DaveWindWatcher/Design-Tools/Practiques/Practica4/pcb-wallpaper.png

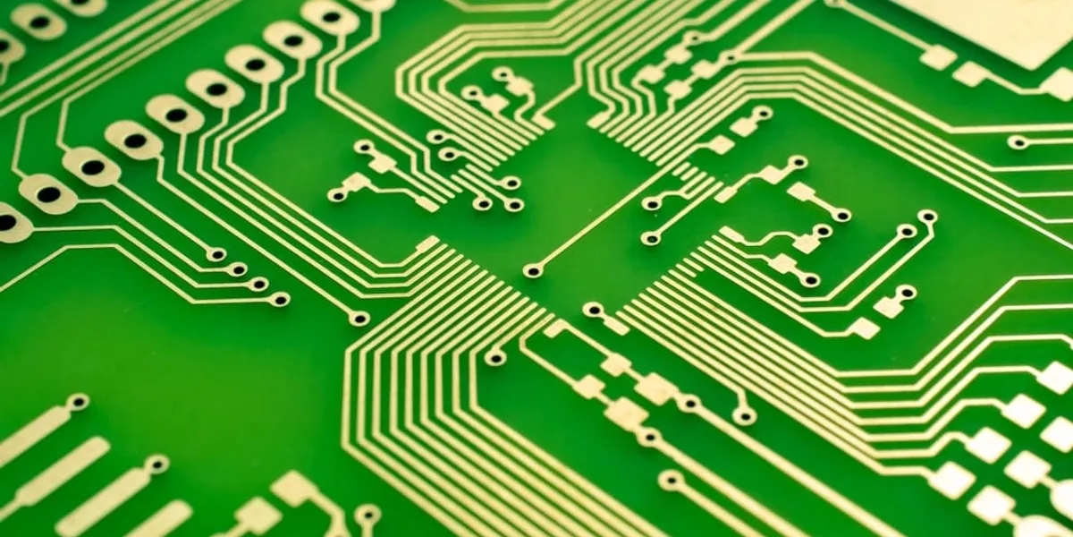
Practiques/Practica4/pcb-wallpaper.png
