DaveWindWatcher/Design-Tools/Practiques/Practica4/Fotitos/1679039151660.jpg

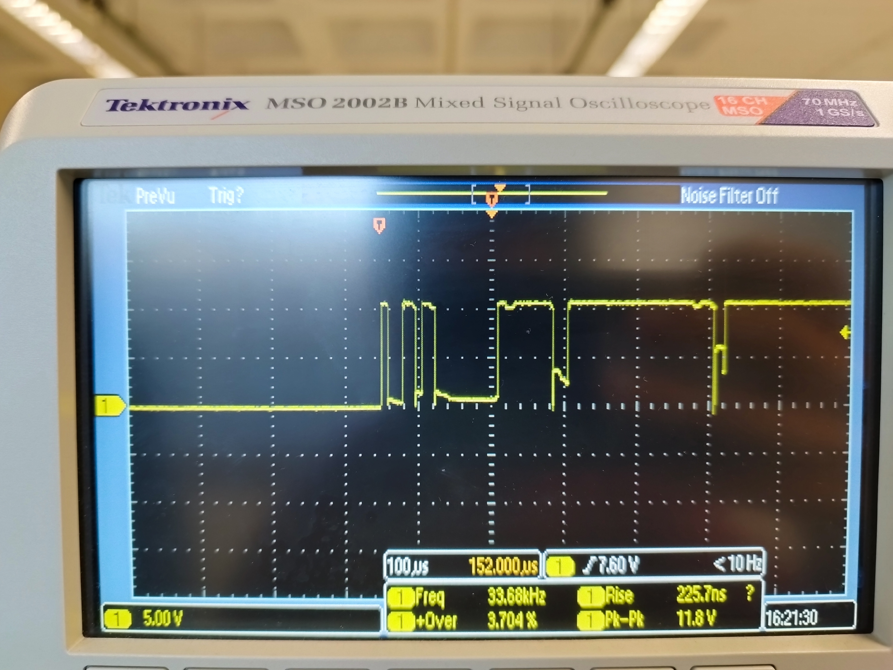
Practiques/Practica4/Fotitos/1679039151660.jpg
