DaveWindWatcher/Design-Tools/README.md

# Design-Tools

Space for the Projects of the subject Dessigns Tool of the Elecronics Engineering Degree.

This course is mainly about PCB design and everything related to it. It is a very practical and application focused course, where students acquire skills in circuit and PCB design. From the conceptualization to the testing pahse and, eventually, the commercialization, going through block diagram and component gathering, schematic and layout and verification. 

### Contents
	I. Practiques
		
		Folder with Lab training, mostly about PCB design.
		
		I.I.	Practica1
		I.II.	Practica2
		I.III.	Practica3
		I.IV.	Practica4
		I.V.	Projecte
