DaveWindWatcher/Design-Tools/Teoria/Ch4 -Decoupling.pdf

### Criteris de Disseny. Cap. IV

### Placement of components

### Component Placement Rules

- Els criteris per col·locar els components en una PCB
– En un circuit d'alta sensibilitat, els components crítics es col·loquen primer, de tal manera que requereixi la mínima longitud de pista per unir els components crítics
– La circuiteria menys crítica es col·loca en l'ordre del flux del senyal. Això minimitzarà la mida de les línies conductores de senyal.
– En un circuit on uns pocs components tenen un nombre considerable de punts de connexió, aquests components seran col·locats primer, distribuint la resta al voltant d'ells

### Component Placement Rules

– Com a regla general, col·loquem primers els components que queden fixats per la seva importància en el circuit, els connectors i interconnexions. Posteriorment es col·loquen la resta de components que es connecten a aquests components primers.
– En quant a la distribució en mida, es col·loquen primer els components més grans, omplint l'espai restant amb els components més petits. – Els components s'han de col·locar de tal forma que sigui senzilla la seva localització a la placa

### Apantallant circuits sensibles

### Soroll i Regles de Disseny

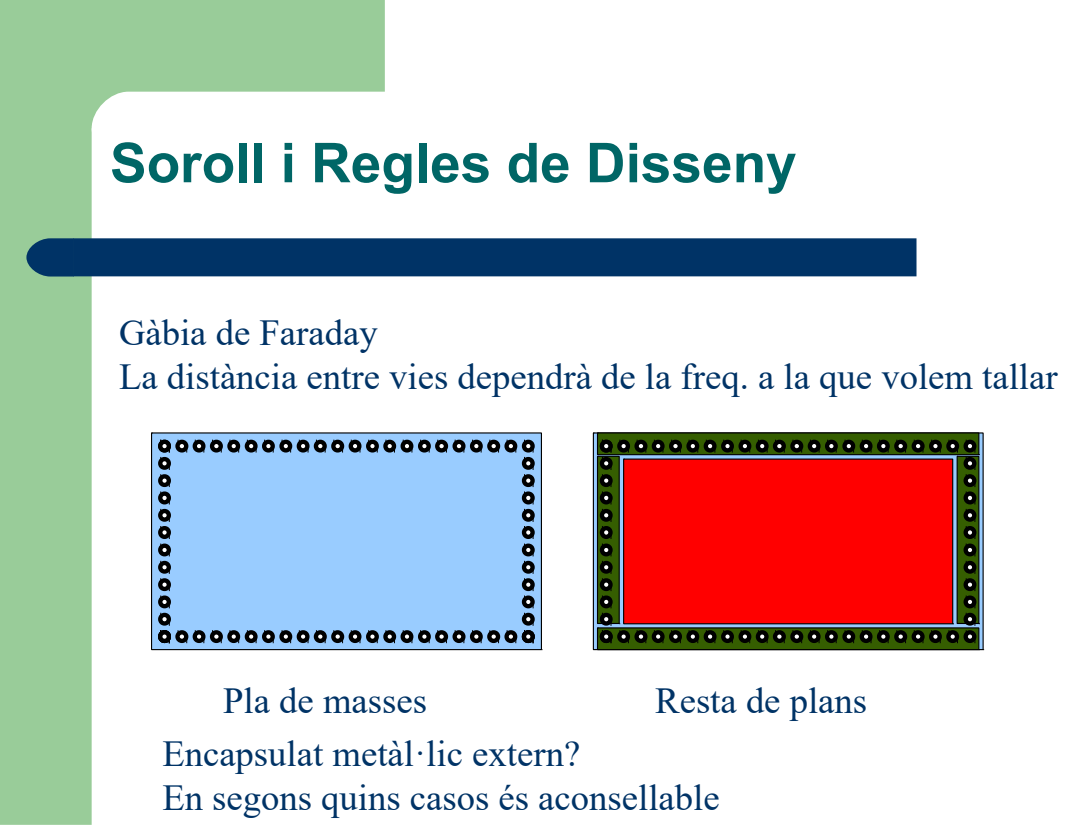
[picture p13: page 6]
Pla de masses; Resta de plans

Gàbia de Faraday
La distància entre vies dependrà de la freq. a la que volem tallar

Encapsulat metàl·lic extern?
En segons quins casos és aconsellable

- La “Gàbia de Faraday” permet contenir las EMI en els perímetres on es poden generar senyals d'altra freqüència
- No està permesa senyals d'entrada / sortida excepte aquelles senyals de comunicació amb l'exterior, i tot i així, degudament filtrades
- Evitar les masses flotants: Les masses flotants o stuffs són penínsules de coure que pengen d'un punt d'unió de masses

### Soroll i Regles de Disseny

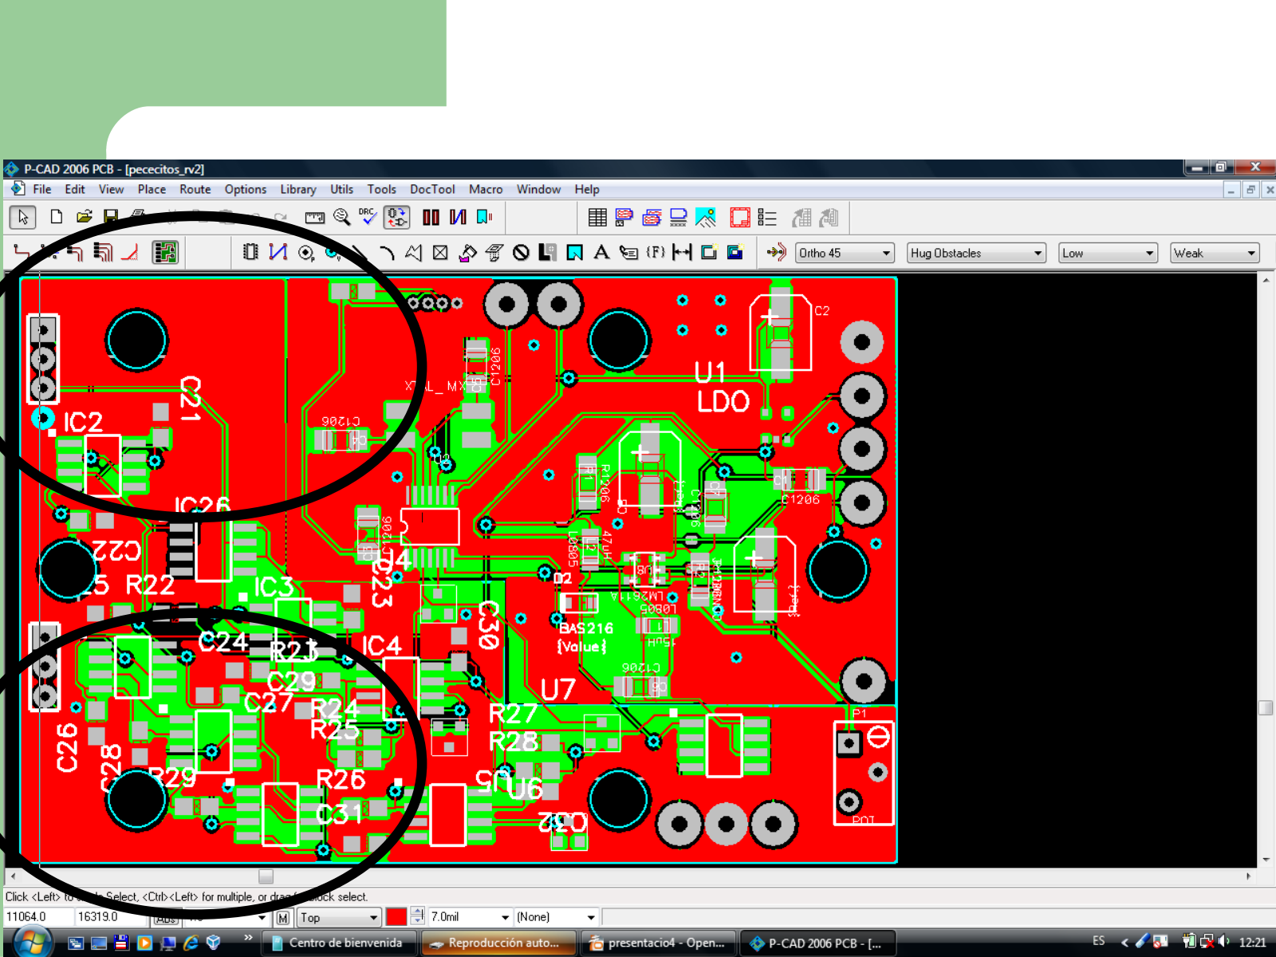
[picture p14: page 8]

### Desacoblament de circuits

### Soroll i Regles de Disseny

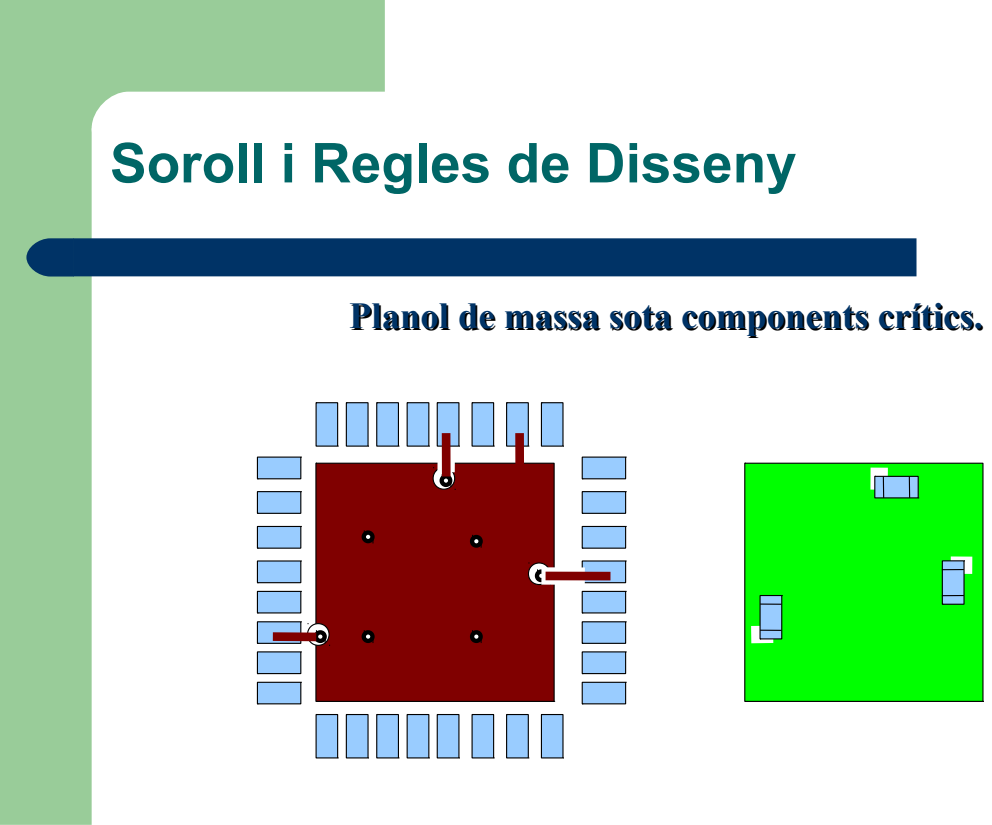
[picture p15: page 10]

Planol de massa sota components crítics.

### Power Supply Decoupling

- El desacoblament de de la font d'alimentació vol dir la disassociació del circuit d'alimentació del bus que dona servei al circuit. Els efectes avantatjosos que presenten són:
– Redueix l'efecte d'un circuit integrat (IC) sobre un altre (Inter-IC-coupling)
– Proporciona una baixa impedància entre Vcc i GND. El IC opera tal i com especifica el fabricant i els enginyers. (Intra-IC-coupling)

### Power Supply Decoupling

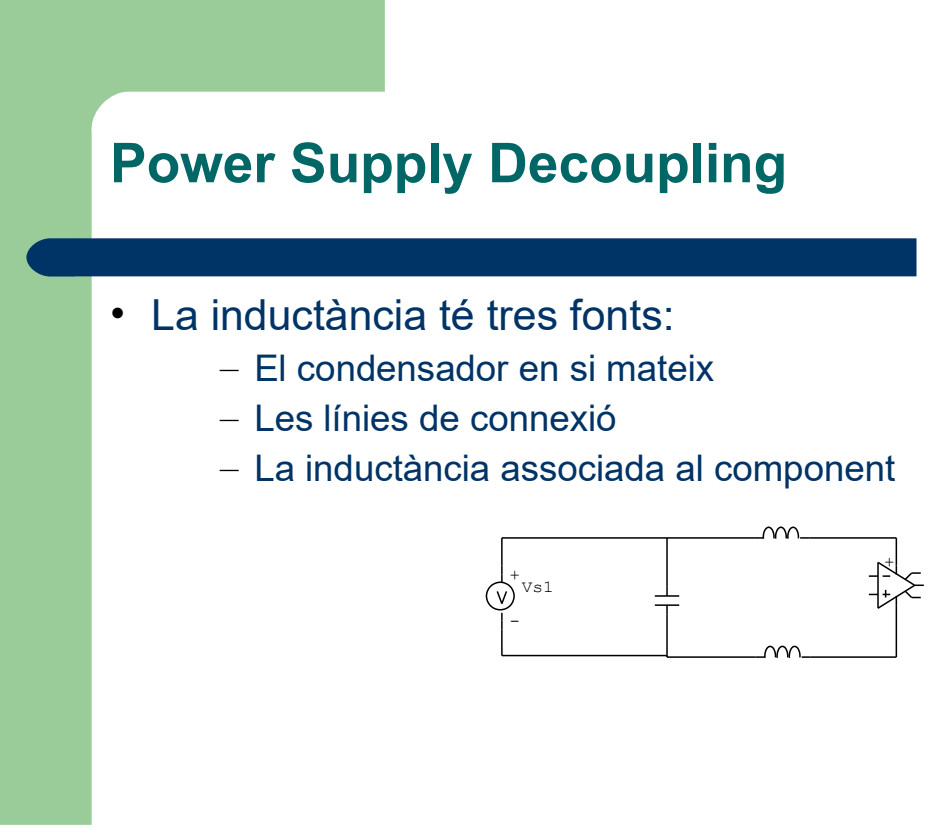
[picture p16: page 12]

• La inductància té tres fonts:
– El condensador en si mateix
– Les línies de connexió
– La inductància associada al component

### Power Supply Decoupling

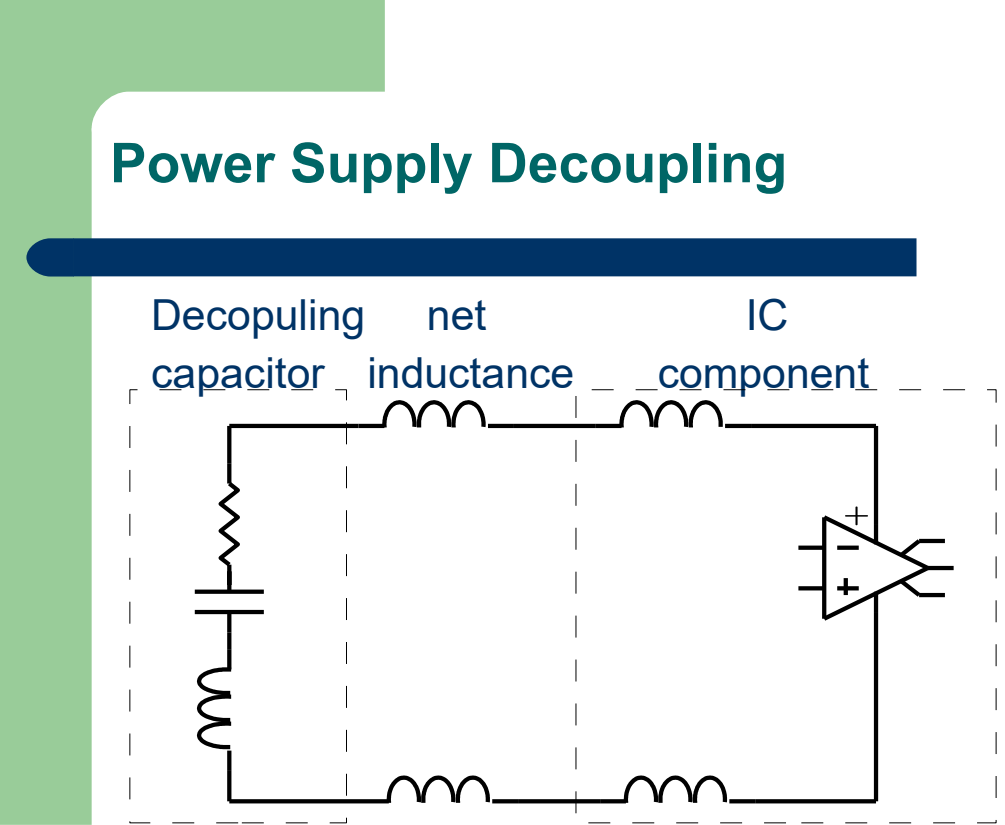
[picture p17: page 13]
Decopuling; net; capacitor inductance; component

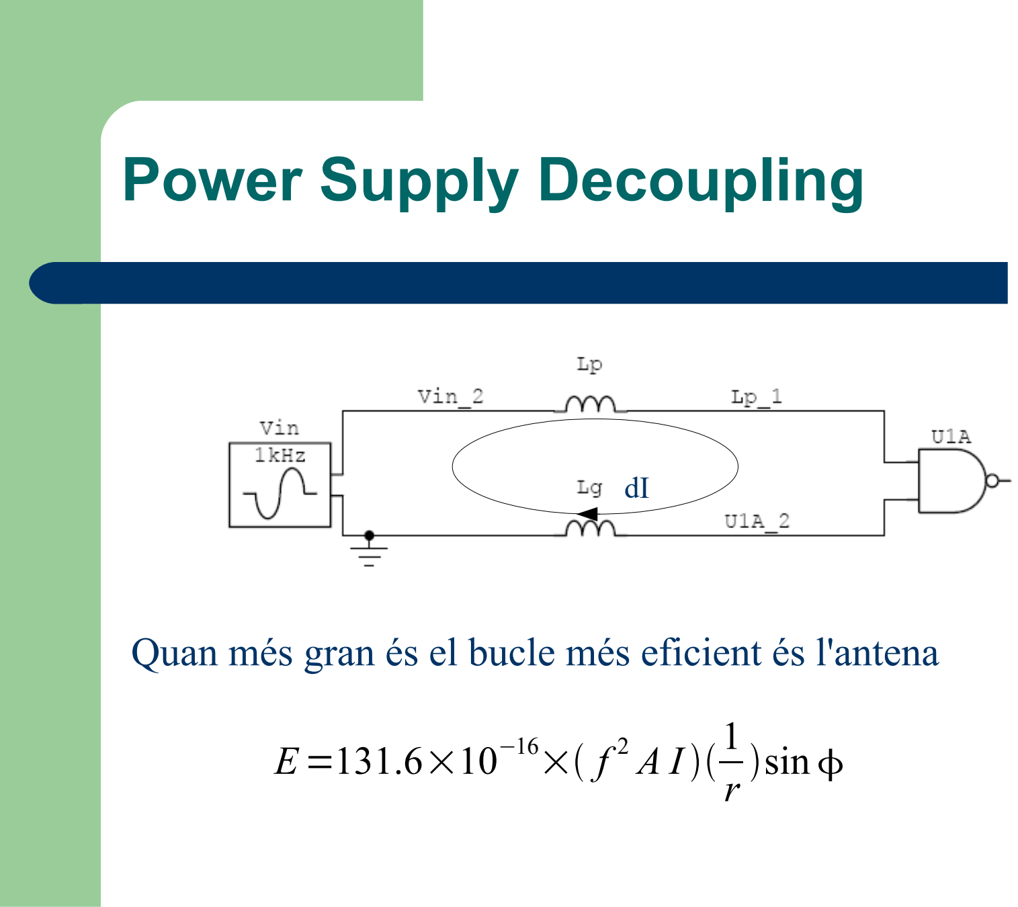
[picture p18: figure]
Power Supply Decoupling; sin

Quan més gran és el bucle més eficient és l'antena

### Power Supply Decoupling

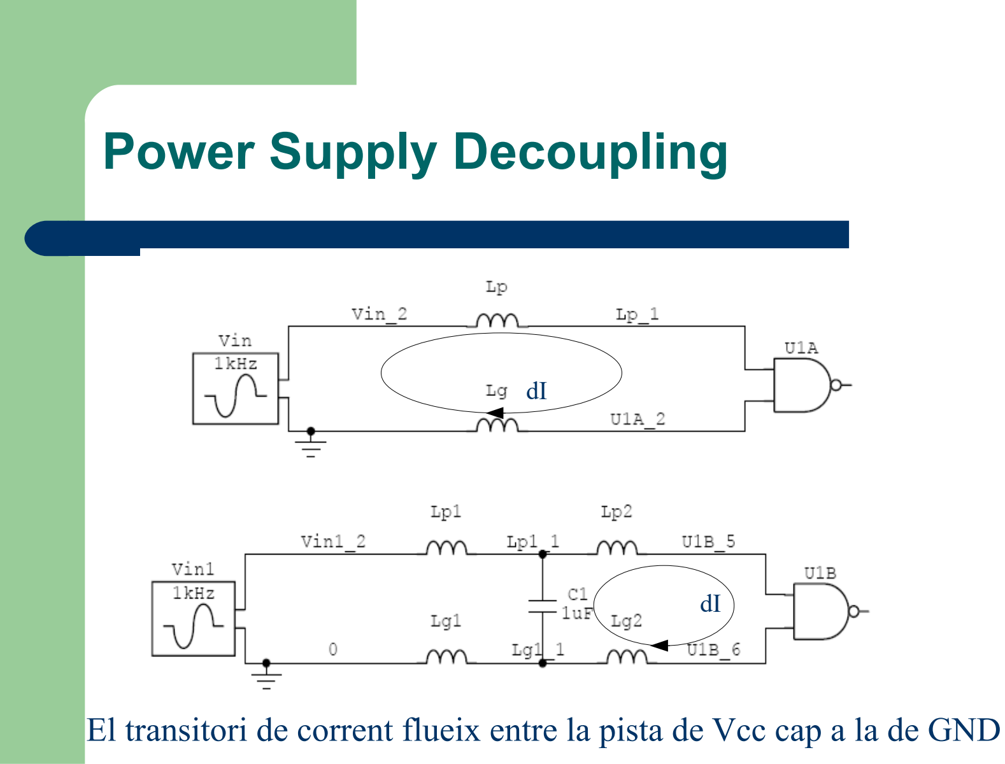
[picture p19: page 15]

dI

dI

El transitori de corrent flueix entre la pista de Vcc cap a la de GND

### Power Supply Decoupling

- El condensador de desacoblament té dos propòsits:
– Proporciona una font de càrrega propera al IC, per tant quan l'IC commuta, el condensador suministra el corrent necessari pel transitori per un camí de baixa impedància
– Proporciona una baixa impedància en AC entre Vcc i GND, minimitzant el soroll injectat en el sistema Vcc/GND per l' IC.

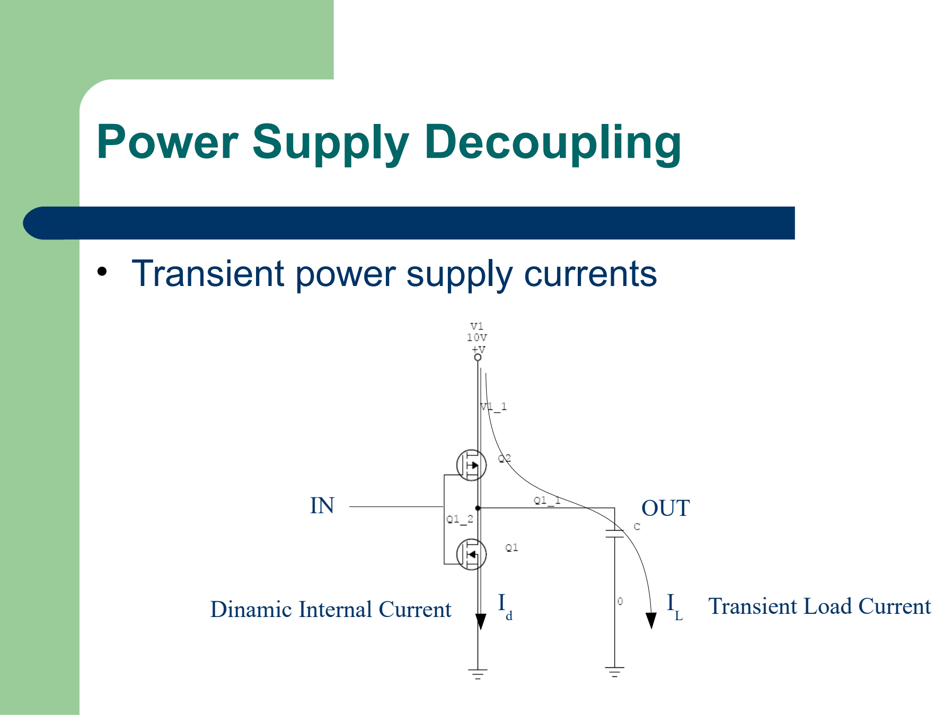
[picture p20: figure]
Power Supply Decoupling; • Transient power supply currents; OUT; I Dinamic Internal Current; Transient Load Current

### Power Supply Decoupling

- Transient Load Current
Aquest fenòmen el trobem associat a la capacitat que tenim a l'entrada de molts Ics – Per exemple, una porta CMOS té una capacitat d'entrada de 7 a 12 pF
El corrent que s'ha de suministrar serà:
- P.e. Un IC operant a 5V amb tr = 1ns té a la sortida 10 CMOS amb 10 pF, Quan val I
L

?

I

L=

nCLV CC
t
r

### Power Supply Decoupling

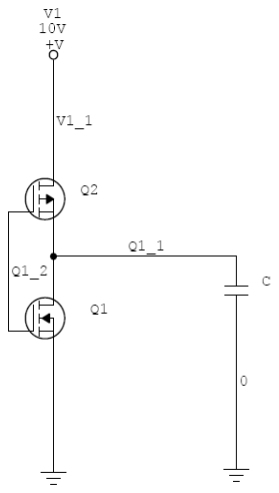
[picture p21: figure]

- Dinamic Internal Current
- Quan un circuit com el de la figura commuta, hi ha un
instant en el que els dos
transistors estan
parcialment conduint,
produint una baixa
impedància entre Vcc i
GND

### Power Supply Decoupling

- El pic de corrent es pot calcular de dos formes en funció de les especs. del datasheet
– Si ens proporcionen la Capacitat de dissipació de potència, Cpd

equivalent a la capacitat interna de l' IC
– En d'altres IC datasheets indiquen el corrent dinàmic d'alimentació ICCD amb unitats A/MHz
I

d=I CCD f
0

o
I

d=

nC pdV CC
t
r

### Power Supply Decoupling

- Espectre de Fourier del transitori de corrent
- Considerant l'aproximació que l'ona de corrent s'aproxima a un triangle isòsceles, l'amplitud del corrent pels diferents

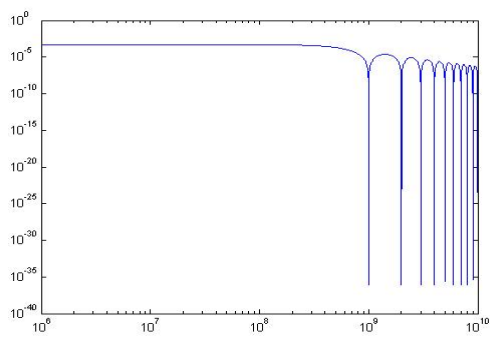
[picture p22: figure]

harmònics ve donada per:

- L'envolvent dels harmònics per una relació tr/T de 0.001 és

I n

=

2 I t
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
### Power Supply Decoupling

- Per sobre d'una freqüència 1/PI tr (freqüència de tall), els harmònics decauen uns 40 dB/dec

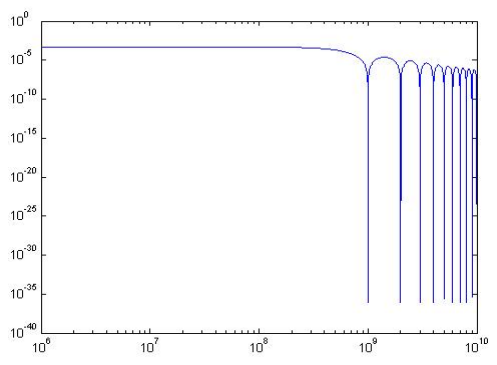
[picture p23: figure]

La freq. de tall ocurrirà a una
freqüència igual a k vegades la freq. fonamental
k no té per que ser un enter

k=
1
T
t

r

### Power Supply Decoupling

- “It is important to note that decoupling is not the process of placing a capacitor adjacent to an IC to supply the transient switching current. Is the process of placing an L-C network adjacent to an IC to supply the transient current”
Henry W. Ott. Electromagnetic Compatibility Engineering

### Power Supply Decoupling

- La inductància interna d'una capacitat SMD és aproximadament de 1 – 2 nH
- La inductància d'una pista de coure oscil·la entre 5 – 20 nH (o més) depenent de les característiques de la pista. Aquestes són les úniques sobre les que tenim cert control!!
- La inductància interna de un IC té un valor que oscil·la entre 3 – 15 nH
- La freqüència de resonància d'un circuit LC sèrie és f
r=

1
2 LC

### Power Supply Decoupling

w = [100000:100000:1000000000] R = 50;
format long
L = 2*10^-9;
C = 10*10^-9;
wl = 2*pi*w*L;
wc = 2*pi*w*C;
format long
length(w)
for x=1:length(w)
Z_r(x) = 0;%R;
Z_i(x) = (wl(x) -1/wc(x)); x
end
Z = Z_r + Z_i *i;
Zmax = max(abs(Z));

loglog( w,abs(Z)/Zmax);

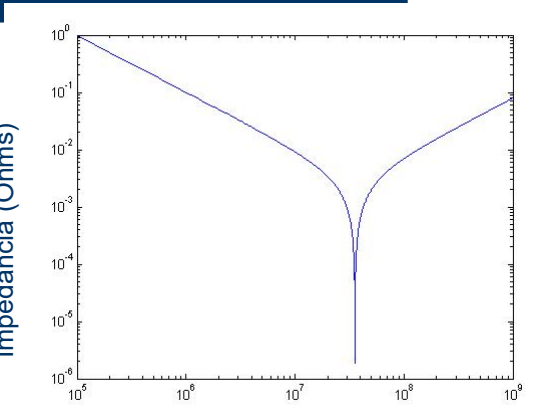
[picture p24: figure]

Freqüència (Hz)

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
### Power Supply Decoupling

- La col·locació d'una capacitad adjacent a un IC és relativament útil per baixes freqüències (per sota dels 50 Mhz)
- En la figura anterior, tenim una capacitat de 10 nF amb una impedància sèrie de 2nH. Veiem que la resonància està cap als 40 Mhz.
- Per sobre d'aquest valor, el comportament és inductiu.

### Power Supply Decoupling

- Tèniques eficiens de desacoblament – Disminuir el Rise Time
– Disminuir el transitori de corrent
– Disminuir la inductància sèrie de les capacitats
– Fer servir múltiples capacitats
- Les dues primeres van contra l'avenç de la tecnologia!! Es poden aplicar en segons quins casos

### Power Supply Decoupling

“Disminuir la inductància en sèrie amb C”
- Disminuir la inductància en sèrie sempre és recomanable en un Circuit integrat, tot i això, en aquest cas no solventa el problema de desacoblament per altes freqüències. Si disminuïm L fins a 1 nH, per una capacitat de 10 nF trobem de nou la freqüència de resonància de 50 MHz

### Power Supply Decoupling

Freqüència ressonància (Mhz) en funció de C i la seva capacitat paràsita

- Per tant no es pot moure la freq. De ressonància de un sol condensador de desacoblament per sobre del centenar de MHz fent servir una capacitat real.
Capacitat (uF) | 5 nH | 10 nH | 15 nH | 20 nH | 30 nH
1 | 2,3 | 1,6 | 1,3 | 1 | 0,9
0,1 | 7,1 | 5 | 4,1 | 3,6 | 3
0,01 | 22,5 | 16 | 13 | 11 | 9
0,001 | 71,2 | 50 | 41 | 36 | 30

### Power Supply Decoupling

- Desacoblament amb múltiples capacitats

– Múltiples capacitats del mateix valor en paral·lel – Múltiples capacitats amb dos valors diferents en paral·lel
– Múltiples capacitats amb molts valors, en paral·lel normalment espaiats una dècada. Per exemple 1uF, 0.1 uF, 0.01 uF, 0.001 uF, 100 pF, etc.

### Power Supply Decoupling

Múltiples capacitats del mateix valor en paral·lel – La capacitat total per n C's del mateix valor és C
t

= nC
– La inductància serà
L
t

= L/n
– Aquesta equació serà correcta si i només si la inductància mútua dels circuits individuals és negligible comparada amb la pròpia inductància. Per tant, les xarxes L-C han d'estar separades físicament per tal de disminuir M.

### Power Supply Decoupling

w = [100000:100000:1000000000] R = 50;
format long
L = 2*10^-9;
C = 10*10^-9;
C1 = 5*10^-9;
C2 = 2.5*10^-9;

wl = 2*pi*w*L;
wc = 2*pi*w*C;
wl1 = 2*pi*w*L/2;
wl2 = 2*pi*w*L/4;
wc1 = 4*pi*w*C1;
wc2 = 8*pi*w*C2;
format long
length(w)
for x=1:length(w)
Z_r(x) = 0;%R;
Z_i(x) = (wl(x) -1/wc(x)); Z_i1(x) = (wl1(x) -1/wc1(x)); Z_i2(x) = (wl2(x) -1/wc2(x)); x
end

Z = Z_r + Z_i *i;
Z1 | = Z_r + Z_i1 *i;
Z2 | = Z_r + Z_i2 *i;
Zmax = max(abs(Z));
Zmax1 = max(abs(Z1));
Zmax2 = max(abs(Z2));

loglog( w,abs(Z)/Zmax);

hold on;

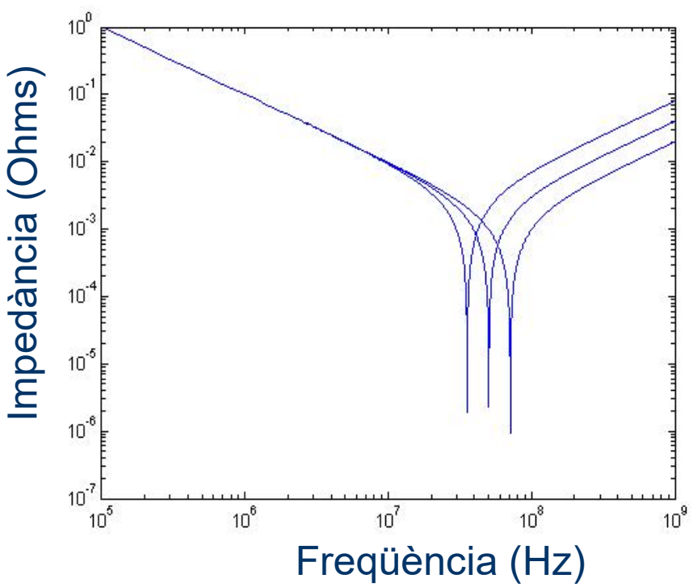
[picture p25: figure]
Freqüència (Hz); cia

loglog(w, abs(Z1)/Zmax1);
hold on;
loglog(w, abs(Z2)/Zmax2);

### Power Supply Decoupling

Múltiples capacitats amb dos valors diferents En algunes circumstàncies es recomana fer servir dos valors de capacitats basant-se en la teoria de que el condensador gran proporcionarà un efectiu desacoblament a baixes freqüències i el petit el proporcionarà a altes freqüències.

### Power Supply Decoupling

- Tenim un problema potencial amb la antiresonància que tenim entre les dues xarxes
- La antiressonància es dona entre les dues freqüències de ressonància de les dues subxarxes.
- La xarxa associada al condensador més petit no te efectes en el desacoblament per freqüències per sota de la freqüència de ressonància del condensador gran

### Power Supply Decoupling

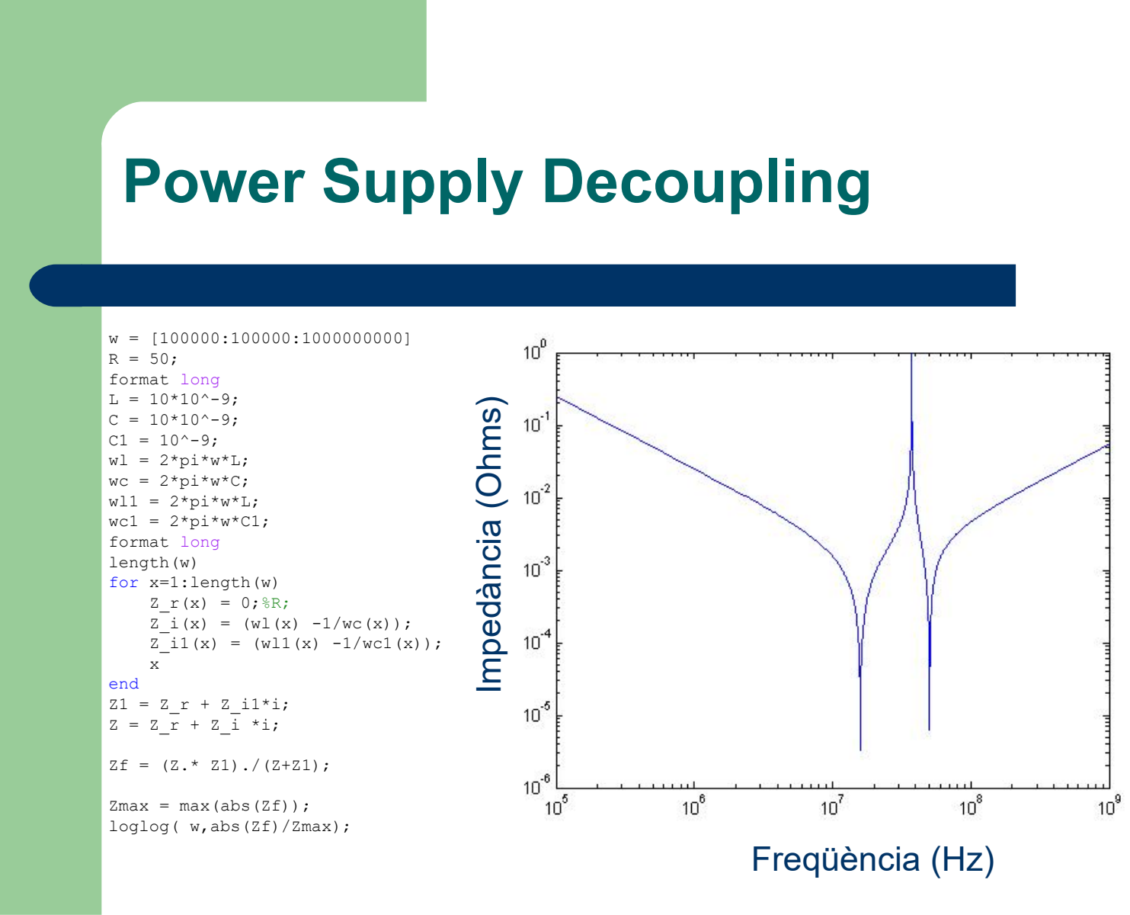
[picture p26: page 35]

w = [100000:100000:1000000000] R = 50;
format long
L = 10*10^-9;
C = 10*10^-9;
C1 = 10^-9;
wl = 2*pi*w*L;
wc = 2*pi*w*C;
wl1 = 2*pi*w*L;
wc1 = 2*pi*w*C1;
format long
length(w)
for x=1:length(w)
Z_r(x) = 0;%R;
Z_i(x) = (wl(x) -1/wc(x)); Z_i1(x) = (wl1(x) -1/wc1(x)); x
end
Z1 = Z_r + Z_i1*i;
Z = Z_r + Z_i *i;

Zf = (Z.* Z1)./(Z+Z1);

Zmax = max(abs(Zf));
loglog( w,abs(Zf)/Zmax);
Freqüència (Hz)

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
### Power Supply Decoupling

- Es millora el desacoblament a freqüències per sobre de la freqüència de ressonància del condensador més petit, ja que la inductància decreix
- El desacoblament serà pitjor a les freqüències intermitjes entre les dues freqüències de ressonància
- Si les dues capacitats tenen una relació 2:1 l'amplitud del pic antiressonat assoleix valors “acceptables”

### Power Supply Decoupling

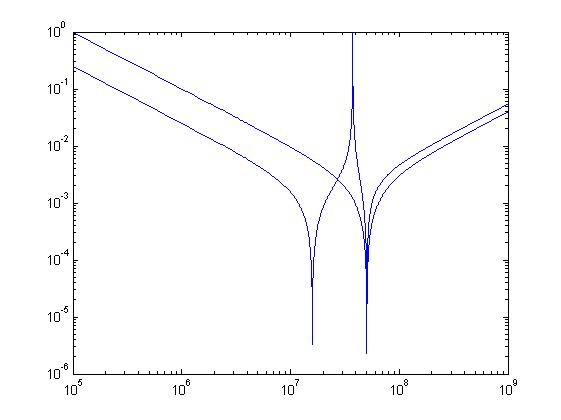
[picture p27: figure]

w = [100000:100000:1000000000] R = 50;
format long
L = 10*10^-9;
C1 = 10*10^-9;
C = 10^-9;
wl = 2*pi*w*L;
wc = 2*pi*w*C;
wl1 = 2*pi*w*L;
wc1 = 2*pi*w*C1;
format long
length(w)
for x=1:length(w)
Z_r(x) = 0;%R;
Z_i(x) = (wl(x) -1/wc(x)); Z_i1(x) = (wl1(x) -1/wc1(x)); x
end
Z1 = Z_r + Z_i1*i;
Z = Z_r + Z_i *i;

Zf = (Z.* Z1)./(Z+Z1);
Zf2 = (Z.*Z)./(2*Z);
Zmax = max(abs(Zf));
loglog( w,abs(Zf)/Zmax);
hold on
Zmax2 = max(abs(Zf2));
loglog( w,abs(Zf2)/Zmax2);

### Power Supply Decoupling

Impedància target
– Per aconseguir una xarxa de desacoblament efectiva, necessitem que la impedància estigui per sota del target pel rang de freqüències d'interès
– Si la impedància target és de 200 mΩ, amb una configuració de 2 capacitats en paral·lel tindrem:

### Power Supply Decoupling

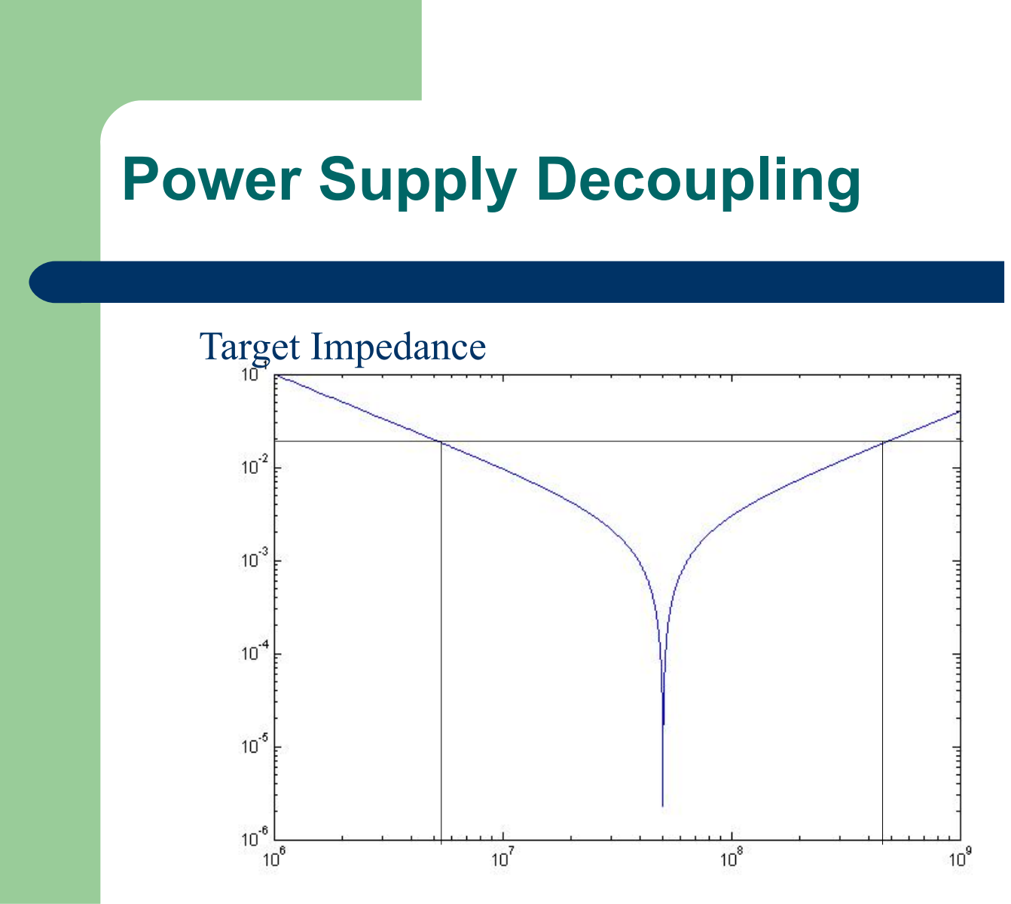
[picture p28: page 39]

Target Impedance

### Power Supply Decoupling

- De l'estudi dels transitoris de corrent en els components sabem que per sobre d'una freq

l'amplitud dels harmònics decauen 40dB/dec. – Per tant la impedància target pot créixer per sobre d'aquesta freqüència sense incrementar el nivell de soroll
– Amb aquesta aproximació podem estimar el nombre de capacitats necessàries per proporcionar un desacoblament efectiu a alta freqüència

f =

1
t
r

### Power Supply Decoupling

- El mínim nombre de capacitats és

L és la inductància de cada capacitat
Z
t

és la impedància objectiu a baixa freq. t
r

és el temps de commutació de la lògica El valor de Z
t

se sol determinar considerant la magnitud del transitori de corrent total i la variació de tensió que permetem per aquest transitori

n=

2 L
Zt

t
r

Zt

=

k dV

dI | k=
1
T
t

r

### Power Supply Decoupling

- Un cop coneguda la impedància objectiu, coneguda la freqüència més baixa d'interès tindrem

El valor de la capacitat obtinguda haurà de satisfer el criteri de transitori de corrent

∣Zt

∣=

1
2 f C

C

dI /dt
dV

### Power Supply Decoupling

Embedded PCB Capacitance
– Si incrementem el nombre de capacitats, en el límit, es pot concloure que la configuració ideal de desacoblament és un nombre infinit de capacitats infinitesimals.
– Per ser efectiva la utilització dels plans de Vcc i GND com capacitats hauria de tenir un valor de uns 1000 pF/in²
– L'espaiat entre capes estàndard es de 0,005 – 0,01 inches, cosa que proporciona una capacitat (FR4) de 1/5 – 1/10 del valor ideal.

C=

Ae
d

1.- La quantitat de corrent necessaria per commutar una sortida de 0 a 1. El nombre de sortides a commutar (N), el temps requerit pel condensador per suministrar corrent (ΔT depen de la freqüència de commutació), i la caiguda de tensió que el sistema pot tolerar ΔV.

C=

I ×N × T
- V

### Power Supply Decoupling

El 18F252A consta de tres ports d'I/O. Dos entades de VCC L'alimentació necessaria són 200mA si commuten tots els pins alhora. ΔV= 0.5V i el temps de commutació està al voltant de 5 nsec.

C=

I×N ×Δ T
Δ V

=

200×20×10×10⁻⁹
0.5

=40 nF

### Power Supply Decoupling

### Power Supply Decoupling

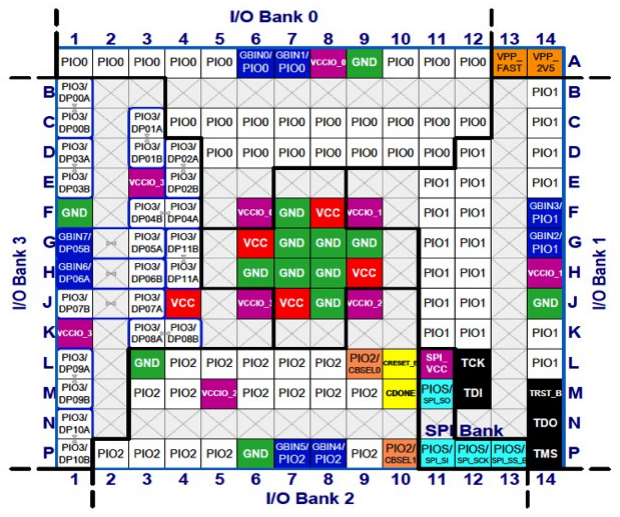
[picture p29: figure]

### Power Supply Decoupling

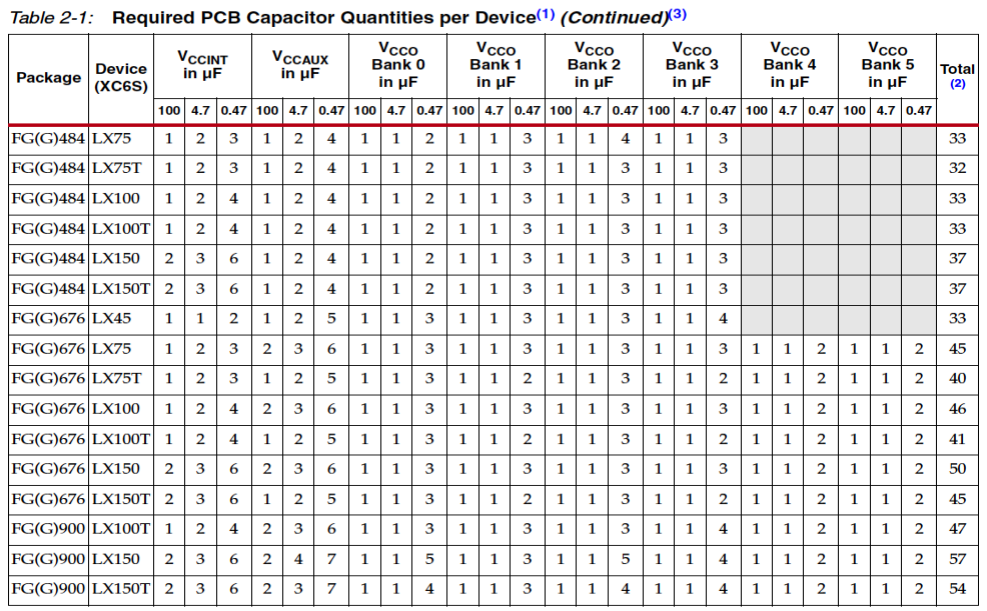
[picture p30: figure]

### Power Supply Decoupling

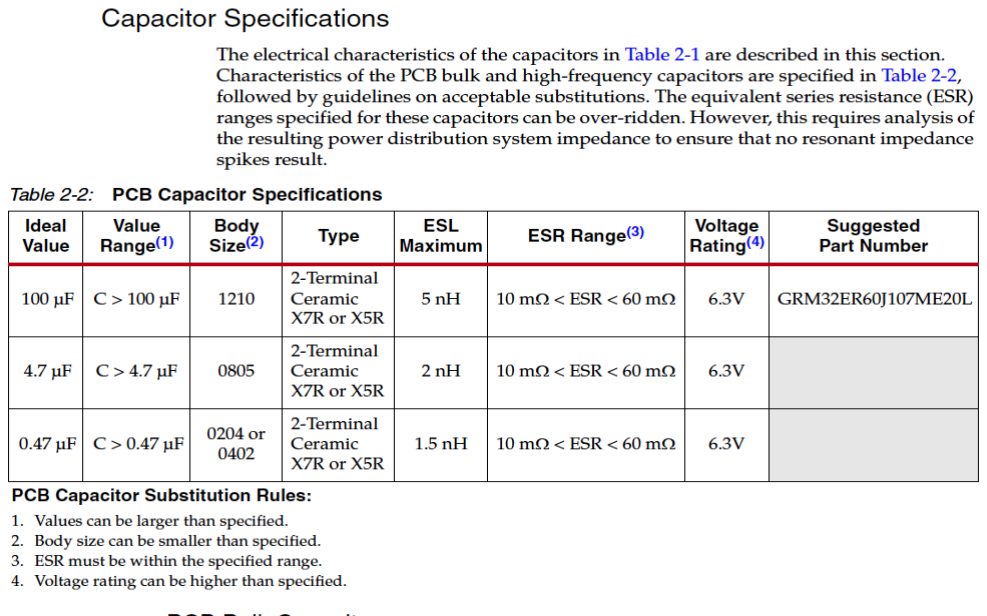
[picture p31: figure]

### Effect of Decoupling on Radiated Emissions

- Els transitoris de corrent en un IC poden produir emissions EM per tres mecanismes diferents: – El flux de corrent produït pel transitori entre el IC i el condensador de desacoblament
– El flux de corrent produït pel transitori a traves de la impedància de GND produirà un voltatge de soroll de GND que pot excitar cables connectats al sistema
– Les tensions de soroll entre Vcc i GND acoblant-se a línies de senyal i interferint en altres IC

### Effect of Decoupling on Radiated Emissions

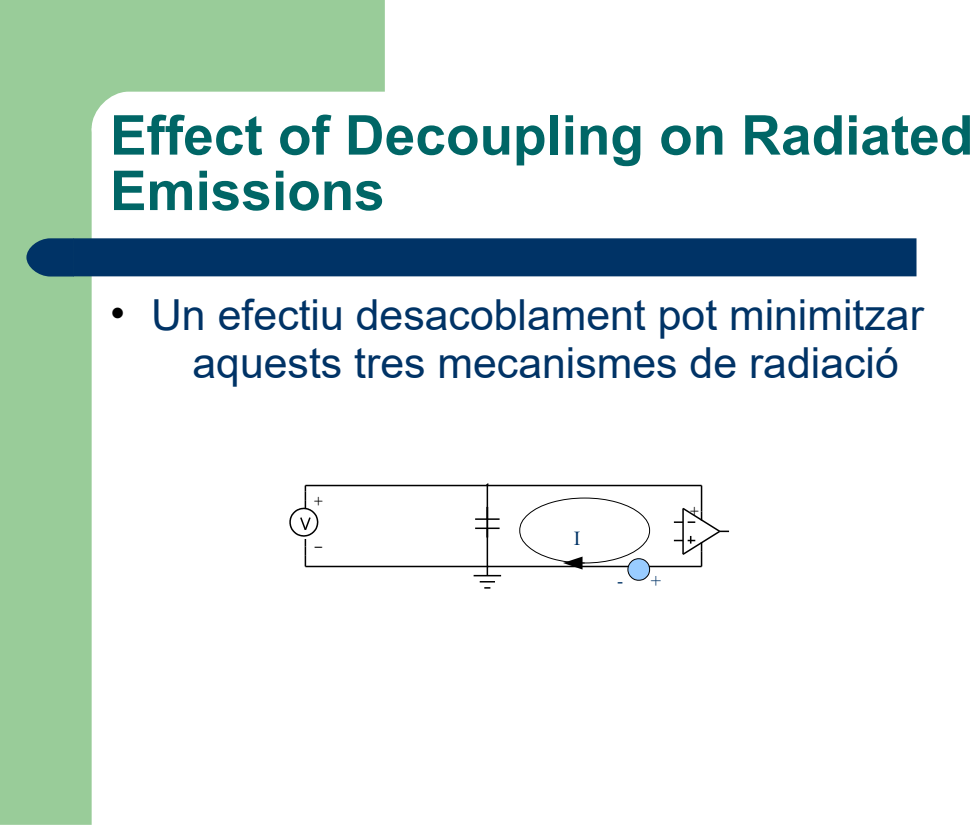
[picture p32: page 50]

• Un efectiu desacoblament pot minimitzar
aquests tres mecanismes de radiació

### Effect of Decoupling on Radiated

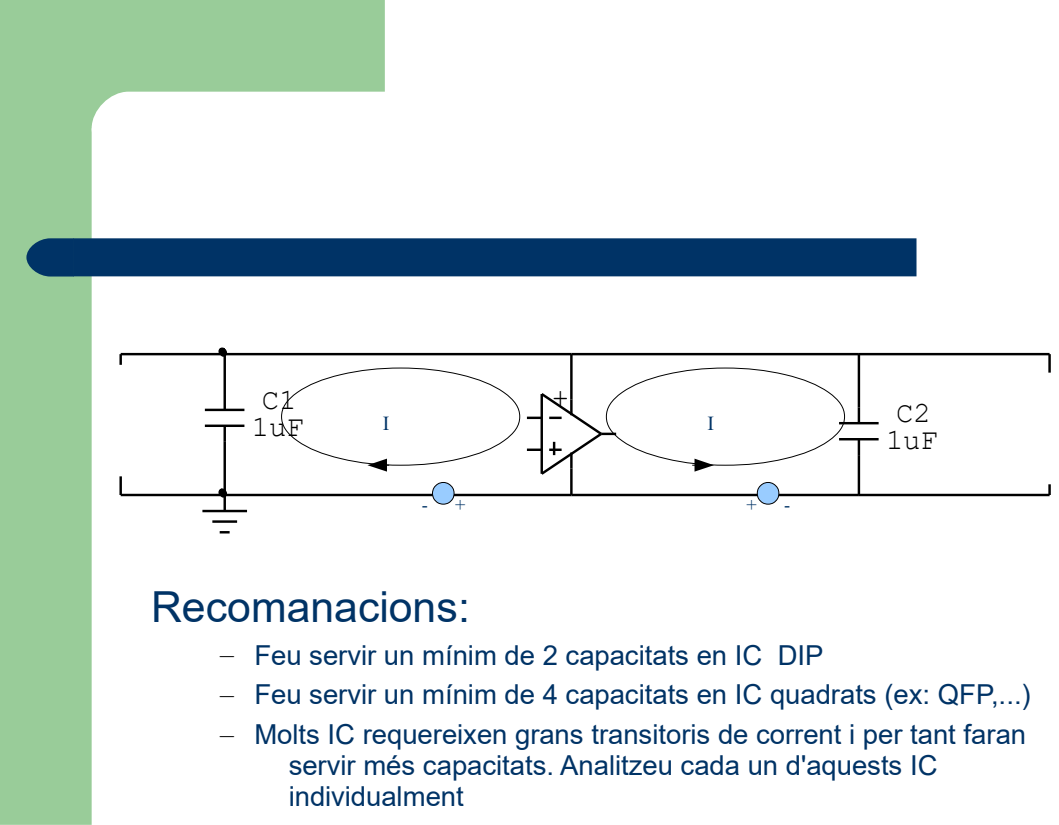
[picture p33: page 51]

Recomanacions:
– Feu servir un mínim de 2 capacitats en IC DIP
– Feu servir un mínim de 4 capacitats en IC quadrats (ex: QFP,...)
– Molts IC requereixen grans transitoris de corrent i per tant faran
servir més capacitats. Analitzeu cada un d'aquests IC
individualment

### Bulk Decoupling Capacitors

- Quan es produeix la commutació en un IC, el condensador de desacoblament proporciona part de la seva càrrega per tal que es produeixi la commutació
- El condensador de Bulk s'encarrega de recarregar els condensadors de desacoblament abans que es produeixi una nova commutació del IC.

### Bulk Decoupling Capacitors

- El condensador de desacoblament treballa a la mateixa velocitat que el IC
- El condensador de Bulk pot treballar a velocitats inferiors. Usualment es configura per treballar a dues vegades la freqüència de rellotge o menys.
- El valor d'aquest condensador no és crític, però hauria de ser superior a la suma de tots els valors dels condensadors de desacoblament que soporta.

### Bulk Decoupling Capacitors

- El primer condensador de Bulk es situa a prop de l'entrada d'alimentació de la placa
- La resta de condensadors de Bulk es coloca de forma estratègica per tal d'alimentar de la forma més ràpida possible als condensadors de desacoblament.
