DaveWindWatcher/Design-Tools/Practiques/Practica2/Correcció_Practica_II_22-23.pdf

Pràctica II.

# Comentaris correcció general

### Eines de Disseny, Curs 22-23

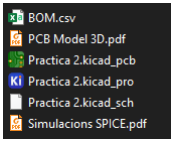
[picture p55: figure]

- Entregar només els arxius que es demanen

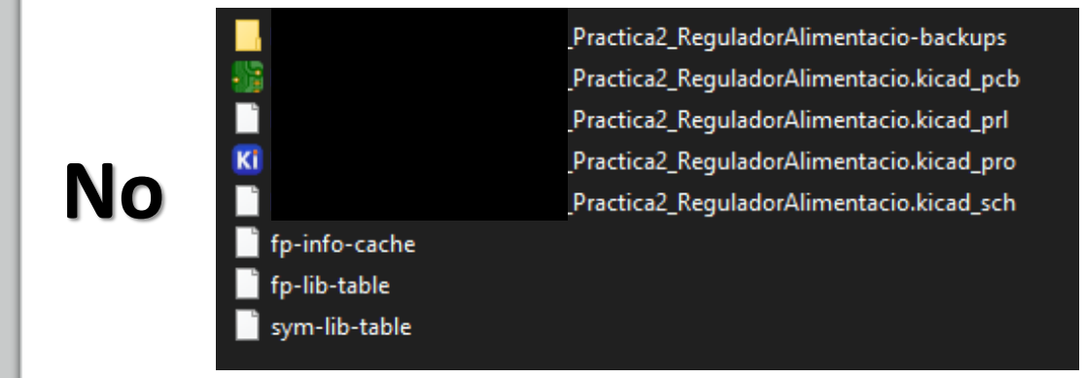
[picture p56: figure]

- Estructura en carpetes queda molt més ordenat
- documents.pdf
- Posar noms descriptius
- evitar entregar backups

# Entrega d’arxius

Sí

- Es demana un únic projecte!!!!
- Dos esquemàtics
- Una única PCB
- Un únic fitxer de simulacions també
- Anar en parelles no vol dir entregar dos fitxers
independents

# Entrega d’arxius

Sí

No

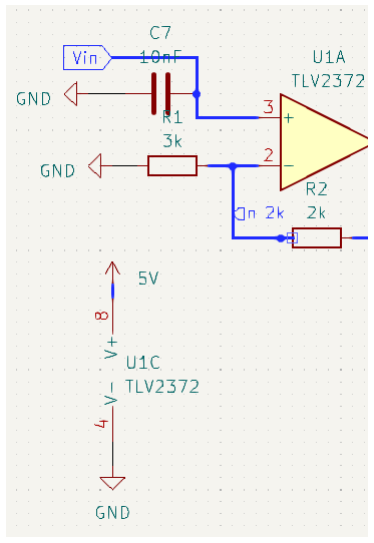
[picture p57: figure]

- Les capacitats de desacoblament sempre van entre l’alimentació i GND
- Capacitats a les entrades de senyal serveixen per filtrar, no es demanen

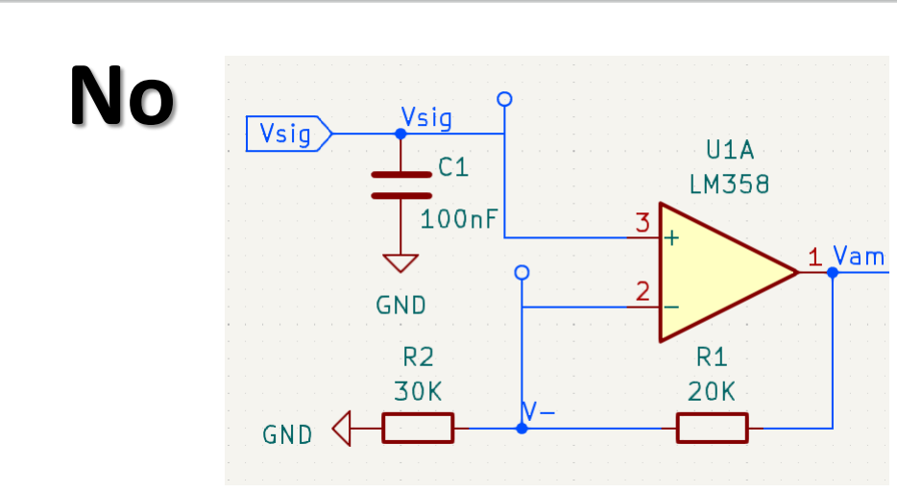
[picture p58: figure]

Disseny | No

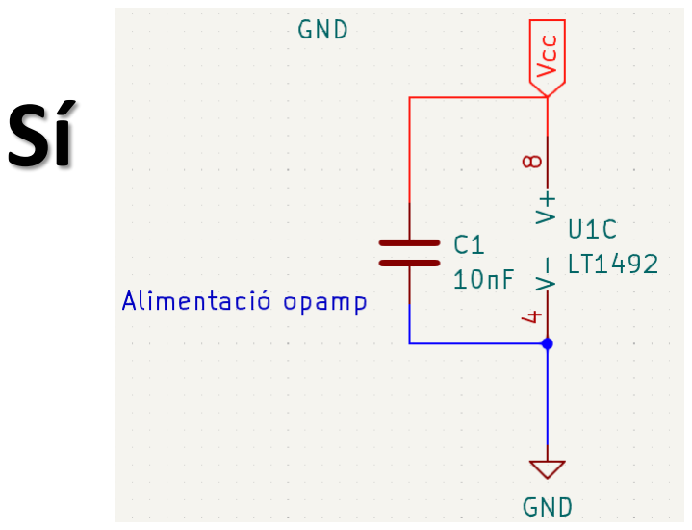
[picture p59: figure]

Schematic | No

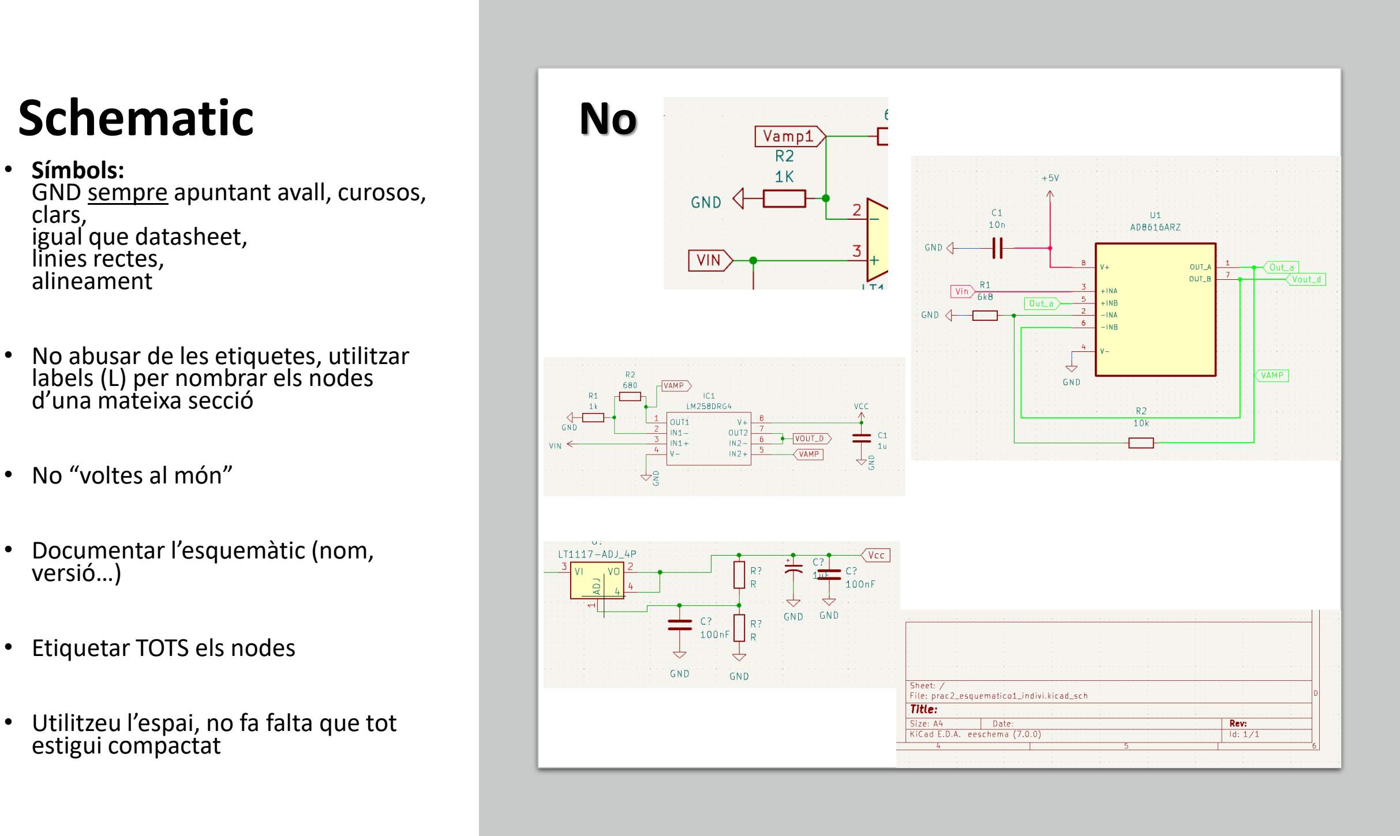
[picture p60: page 5]

- Símbols:
GND sempre apuntant avall, curosos, clars,
igual que datasheet,
linies rectes,
alineament
- No abusar de les etiquetes, utilitzar labels (L) per nombrar els nodes d’una mateixa secció
- No “voltes al món”
- Documentar l’esquemàtic (nom, versió…)
- Etiquetar TOTS els nodes
- Utilitzeu l’espai, no fa falta que tot estigui compactat

Schematic | Sí

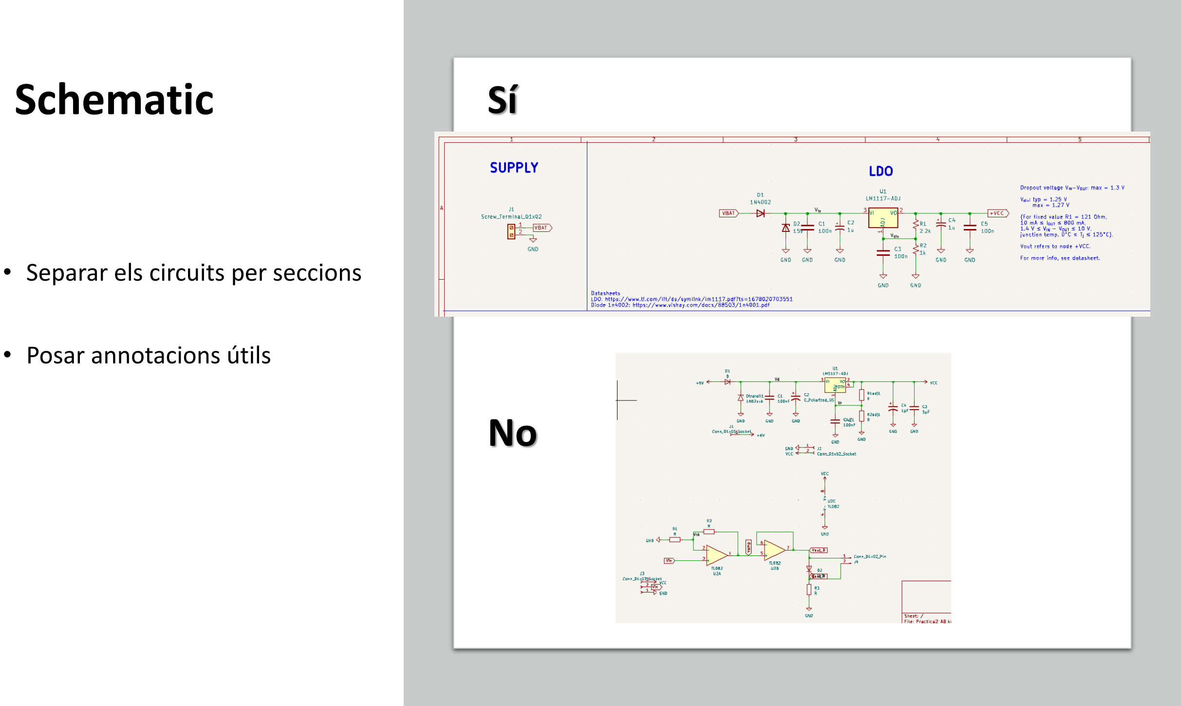
[picture p61: page 6]

- Separar els circuits per seccions
- Posar annotacions útils
No

PCB Layout | No

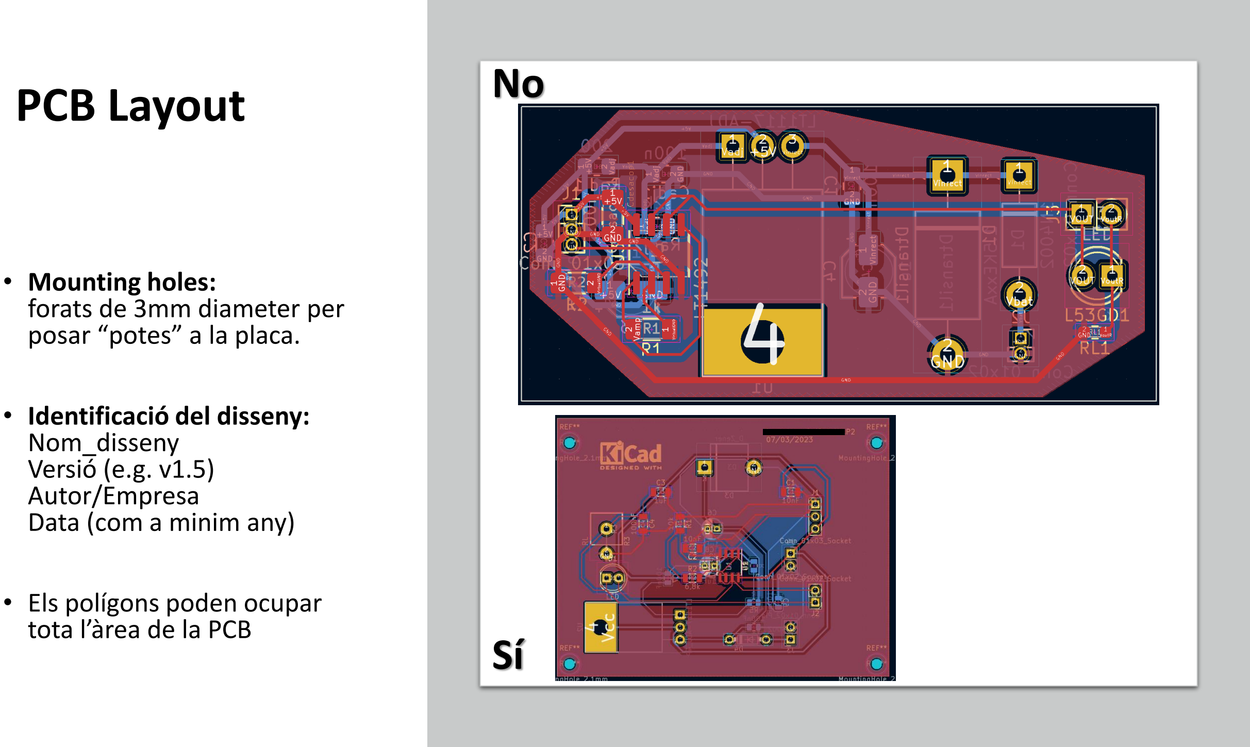
[picture p62: page 7]

- Mounting holes:
forats de 3mm diameter per posar “potes” a la placa.
- Identificació del disseny: Nom_disseny
Versió (e.g. v1.5)
Autor/Empresa
Data (com a minim any)
- Els polígons poden ocupar tota l’àrea de la PCB
Sí

PCB Layout | No

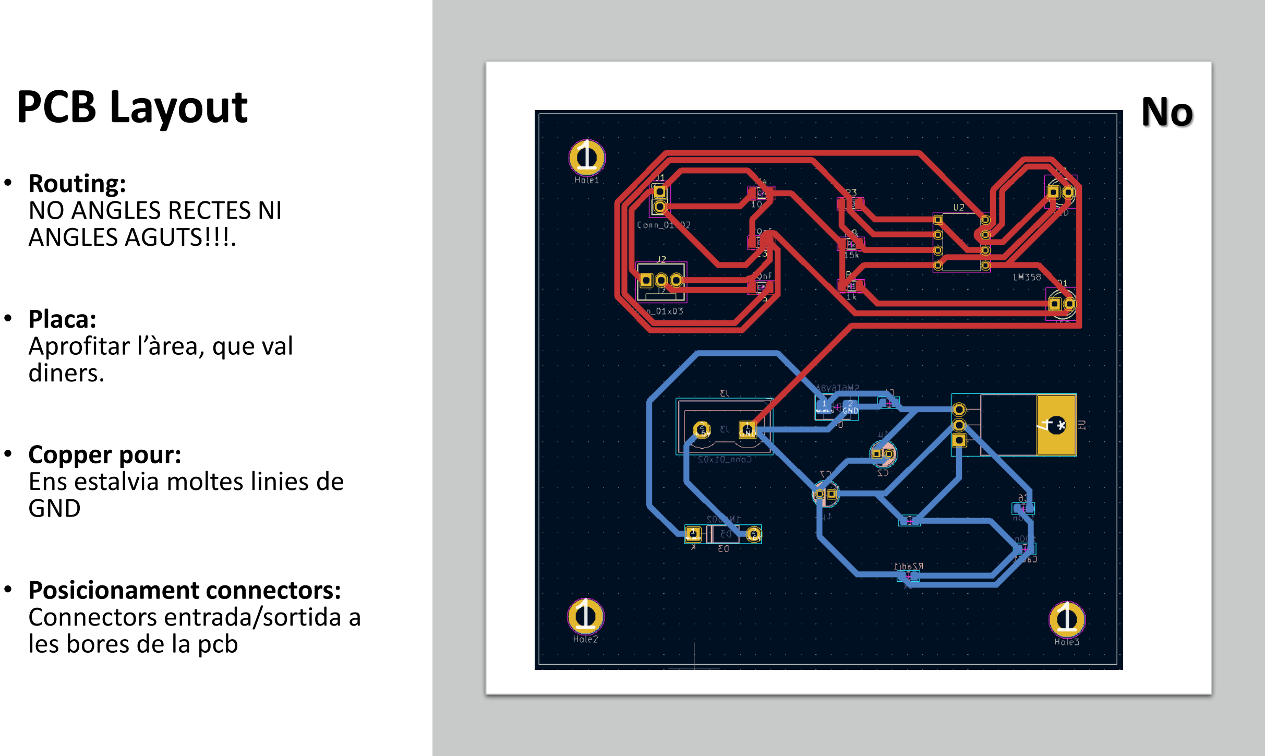
[picture p63: page 8]

- Routing:
NO ANGLES RECTES NI
ANGLES AGUTS!!!.
- Placa

:
Aprofitar l’àrea, que val
diners.
- Copper pour:
Ens estalvia moltes linies de GND
- Posicionament connectors: Connectors entrada/sortida a les bores de la pcb

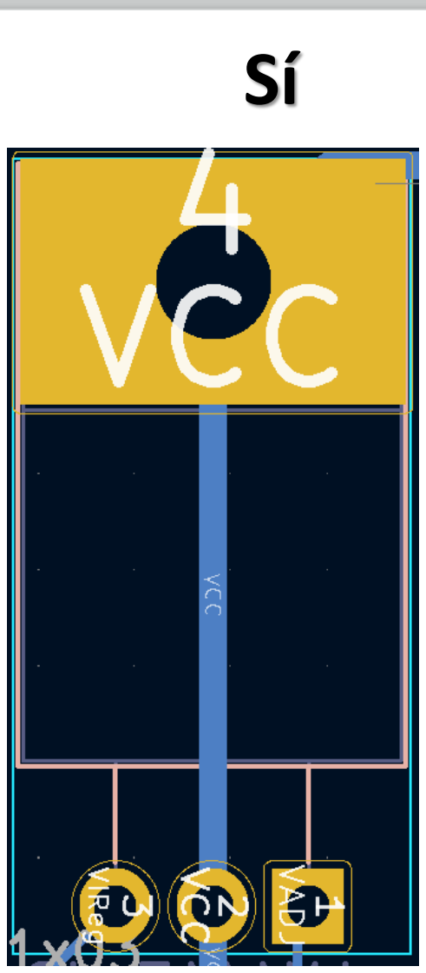
[picture p64: figure]
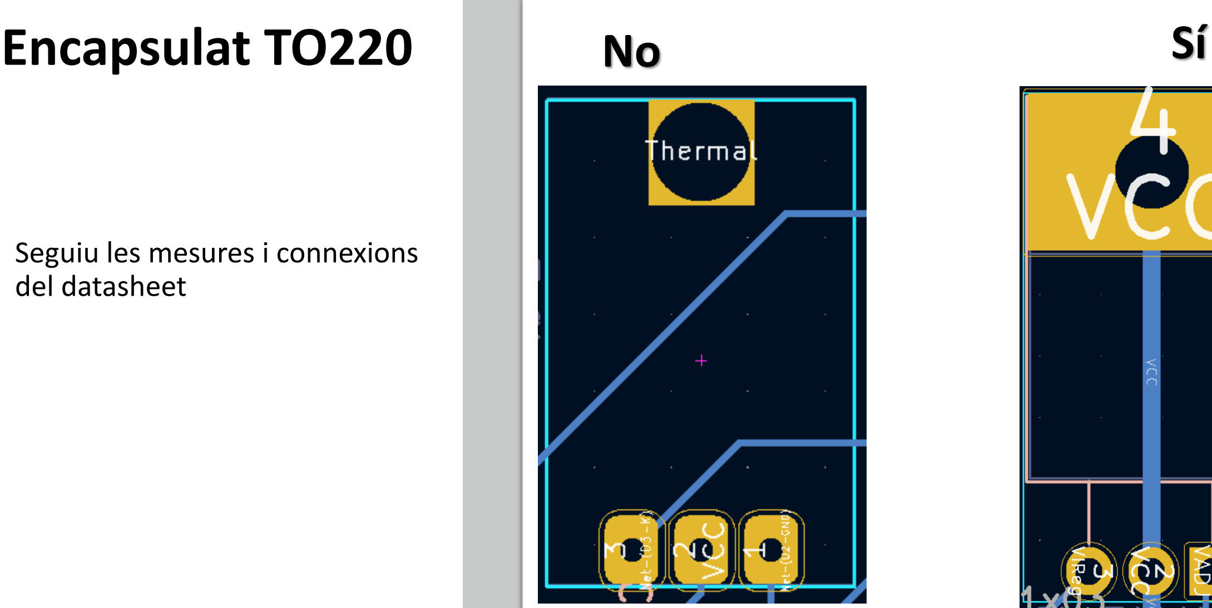
[picture p65: figure]
Encapsulat TO220

- Seguiu les mesures i connexions del datasheet

Simulacions | No

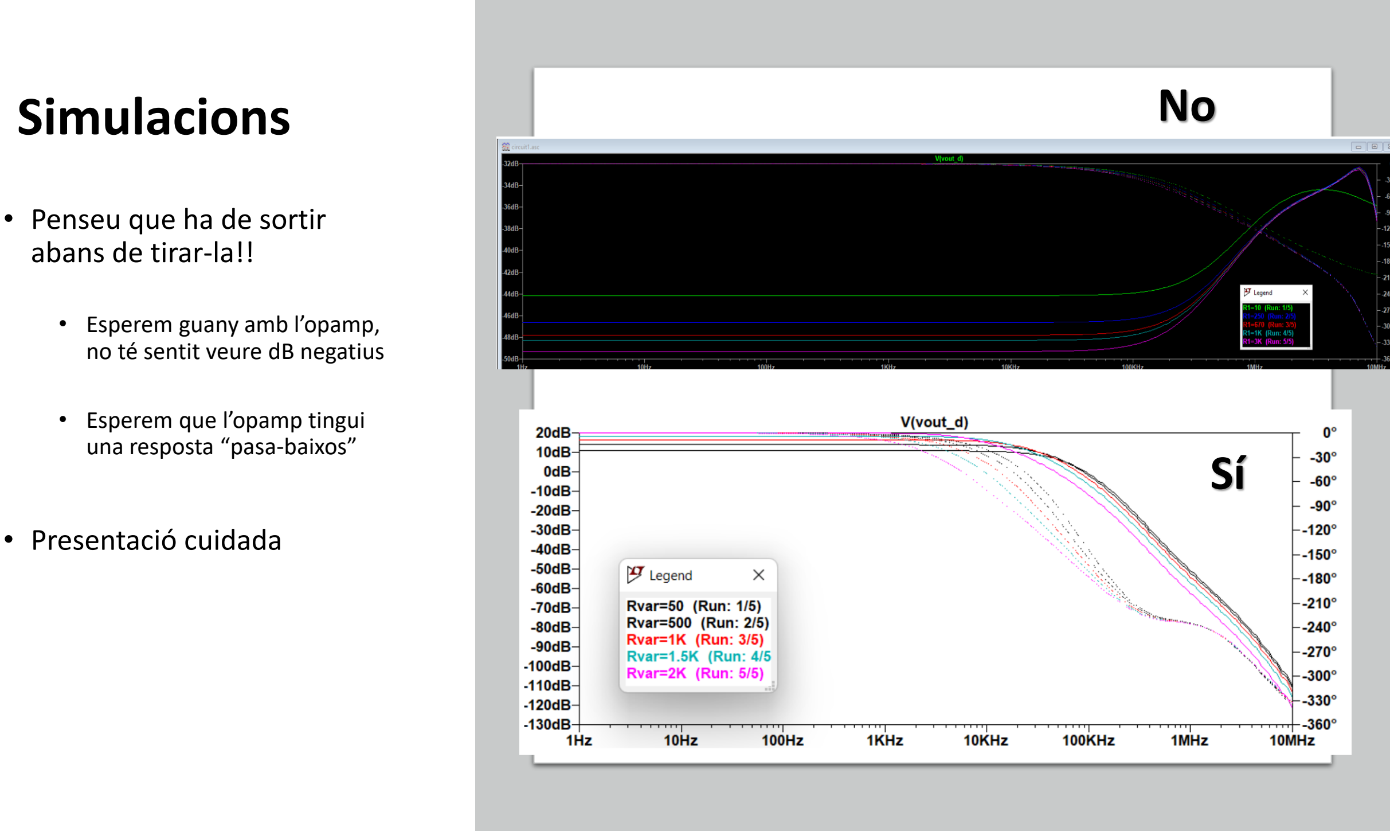
[picture p66: page 10]

- Penseu que ha de sortir
abans de tirar

-la!!

- Esperem guany amb l’opamp, no té sentit veure dB negatius
- Esperem que l’opamp tingui una resposta “pasa

-baixos

”

- Presentació cuidada

Sí
