DaveWindWatcher/Design-Tools/Practiques/Practica3/DavidMiravent_AidarIglesias_P3/Captures_3d/AidarIglesias_DavidMiravent_P3.jpg

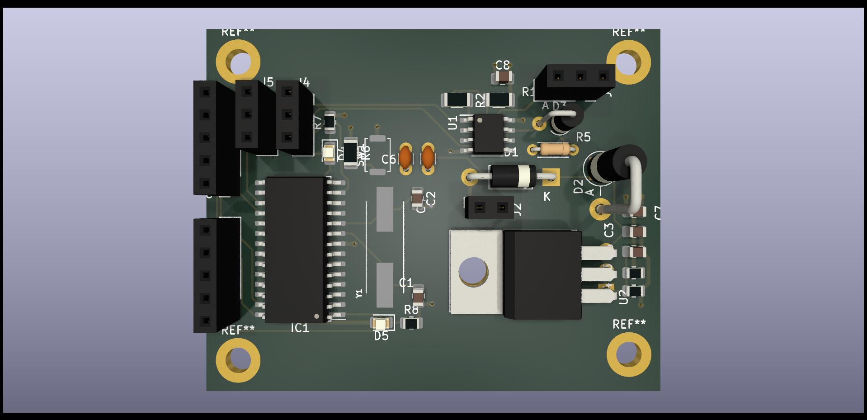
Practiques/Practica3/DavidMiravent_AidarIglesias_P3/Captures_3d/AidarIglesias_DavidMiravent_P3.jpg
