DaveWindWatcher/Design-Tools/Practiques/Practica3/DavidMiravent_AidarIglesias_P3/Captures_3d/AidarIglesias_DavidMiravent_P3_II.jpg

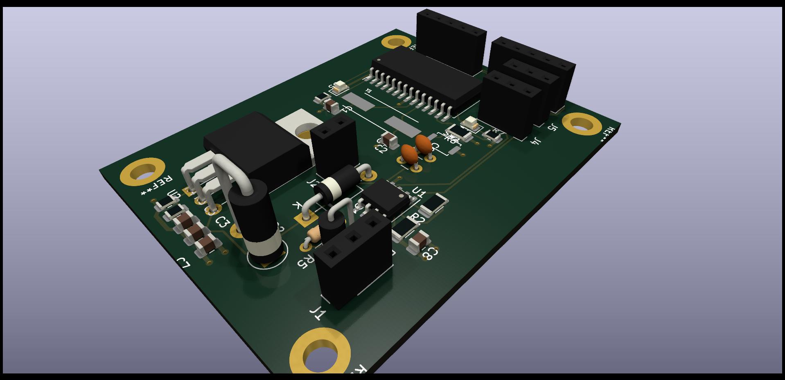
Practiques/Practica3/DavidMiravent_AidarIglesias_P3/Captures_3d/AidarIglesias_DavidMiravent_P3_II.jpg
