DaveWindWatcher/Design-Tools/Practiques/Practica4/Fotitos/1679039151651.jpg

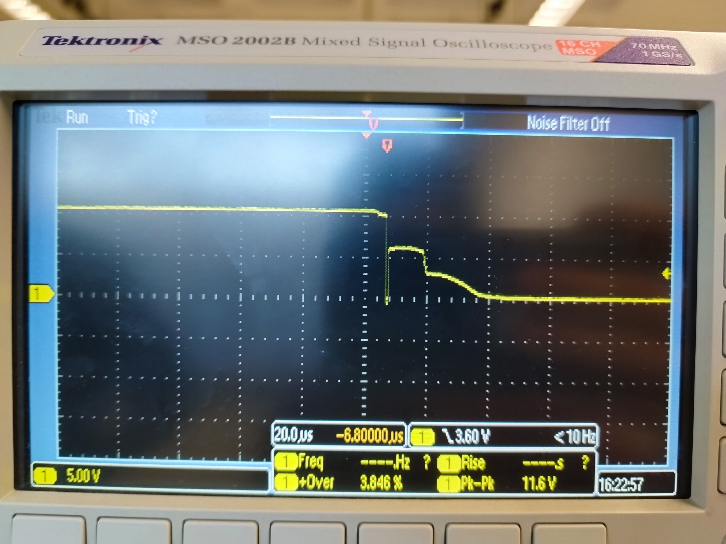
Practiques/Practica4/Fotitos/1679039151651.jpg
