DaveWindWatcher/Design-Tools/Practiques/Practica4/Fotitos/TEK00000.PNG

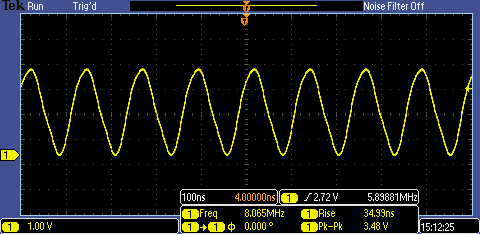
Practiques/Practica4/Fotitos/TEK00000.PNG
