DaveWindWatcher/Design-Tools/Practiques/Practica4/Fotitos/TEK00001.PNG

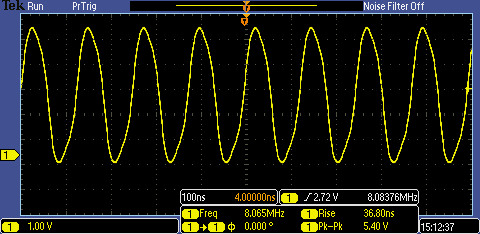
Practiques/Practica4/Fotitos/TEK00001.PNG
