DaveWindWatcher/Design-Tools/Practiques/Practica4/Fotitos/TEK00002.PNG

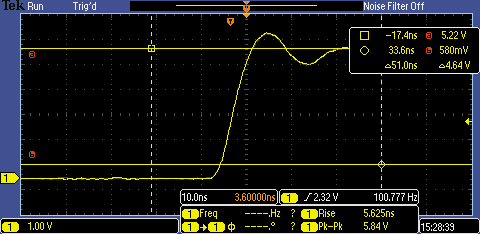
Practiques/Practica4/Fotitos/TEK00002.PNG
