DaveWindWatcher/Design-Tools/Practiques/Practica4/Fotitos/TEK00003.PNG

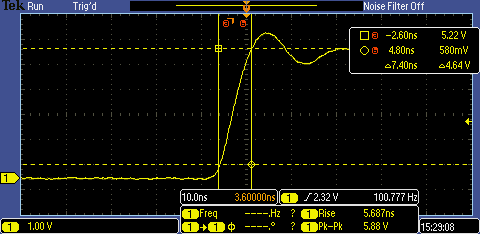
Practiques/Practica4/Fotitos/TEK00003.PNG
