DaveWindWatcher/Design-Tools/Practiques/Practica4/Fotitos/TEK00004.PNG

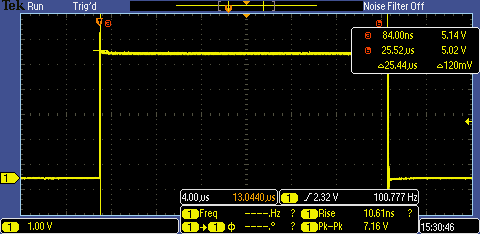
Practiques/Practica4/Fotitos/TEK00004.PNG
