DaveWindWatcher/Design-Tools/Practiques/Practica4/Fotitos/TEK00005.PNG

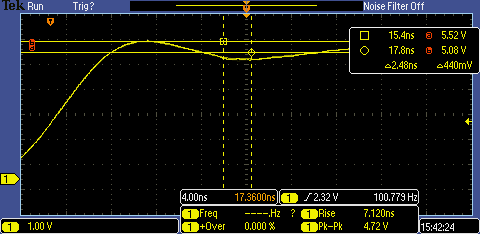
Practiques/Practica4/Fotitos/TEK00005.PNG
