DaveWindWatcher/Design-Tools/Practiques/Practica3/LIB_PIC18F258-I_SO/PIC18F258-I_SO/3D/PIC18F258-I_SO.stp

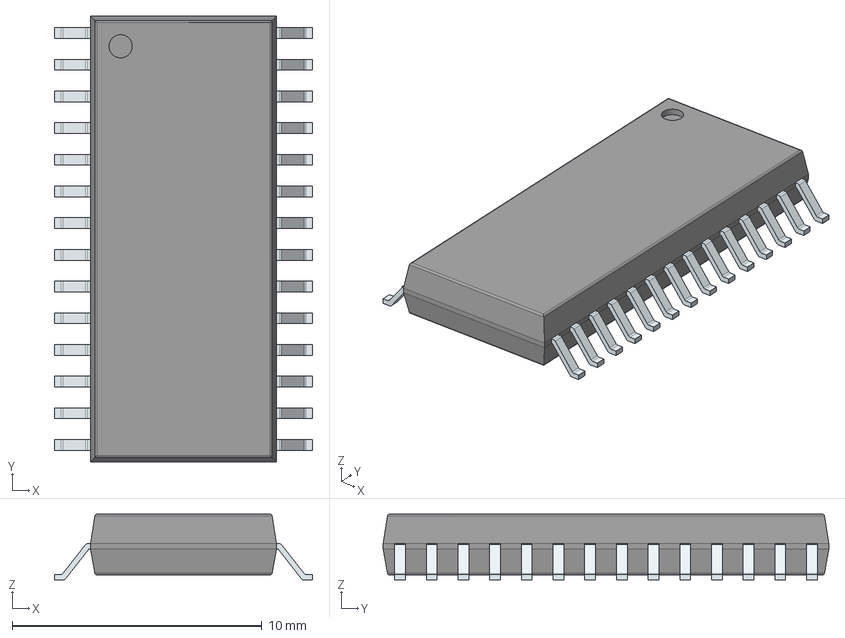
[picture p93: CAD file, 2023-03-13]
Practiques/Practica3/LIB_PIC18F258-I_SO/PIC18F258-I_SO/3D/PIC18F258-I_SO.stp
10.3 x 17.9 x 2.64 mm
PinsArrayLR
