DaveWindWatcher/Design-Tools/(list of files, cad)

Other CAD files:
Practiques/Practica3/LIB_PIC18F258-I_SO/PIC18F258-I_SO/Allegro/soic127p1034x264-28n.psm
Practiques/Practica3/LIB_PIC18F258-I_SO/PIC18F258-I_SO/DEHDL/pic18f258_i_so/chips/chips.prt
