DaveWindWatcher/Design-Tools/Practiques/Practica4/pcb.pdf

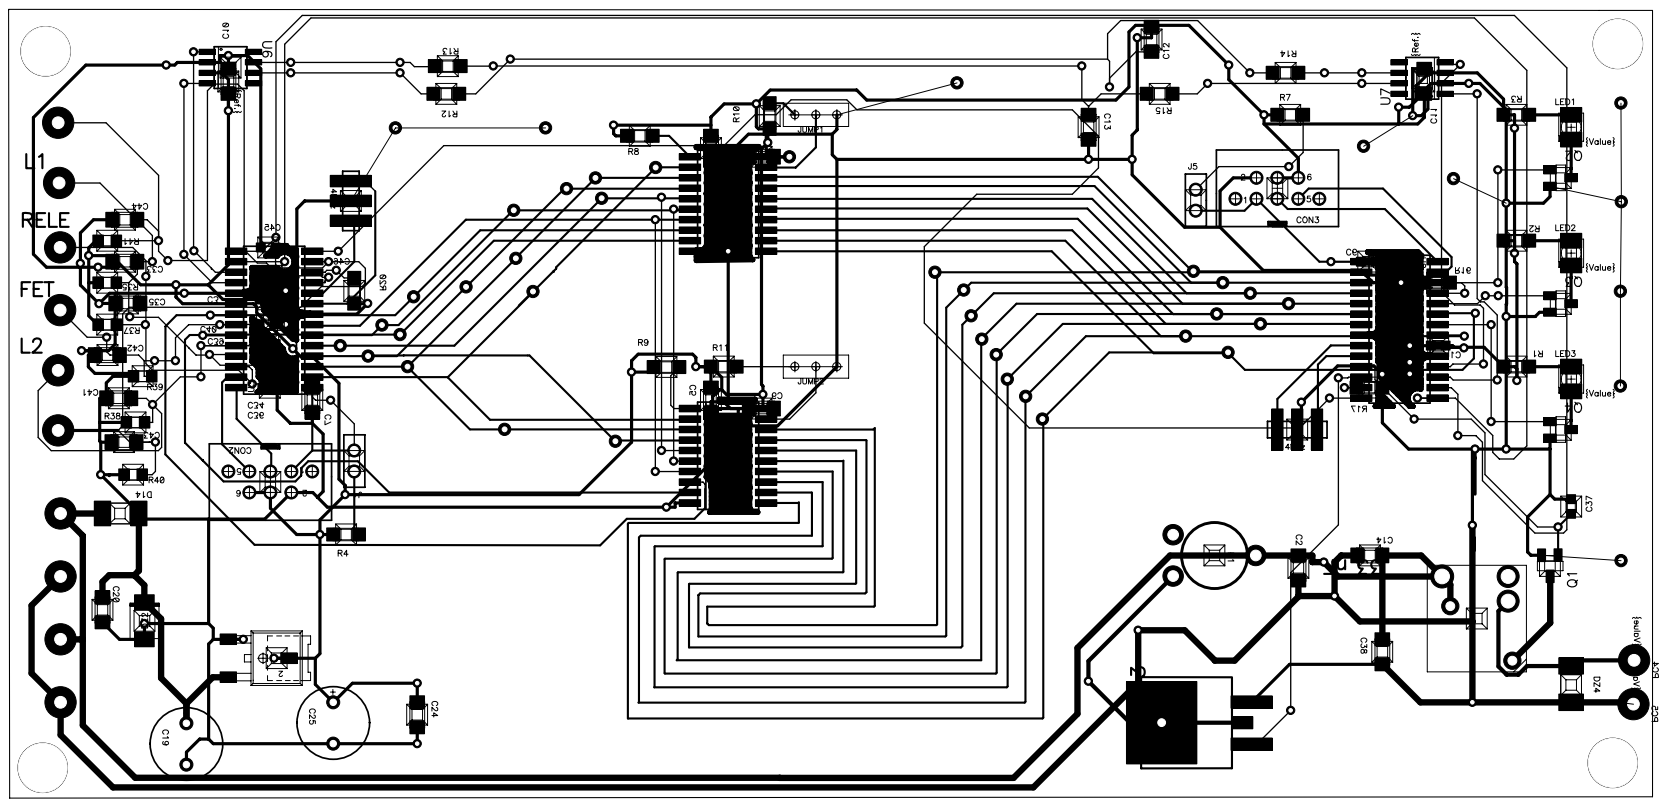
[picture p117: page 1]
