DaveWindWatcher/Design-Tools/Practiques/Practica4/sch_sheet1.pdf

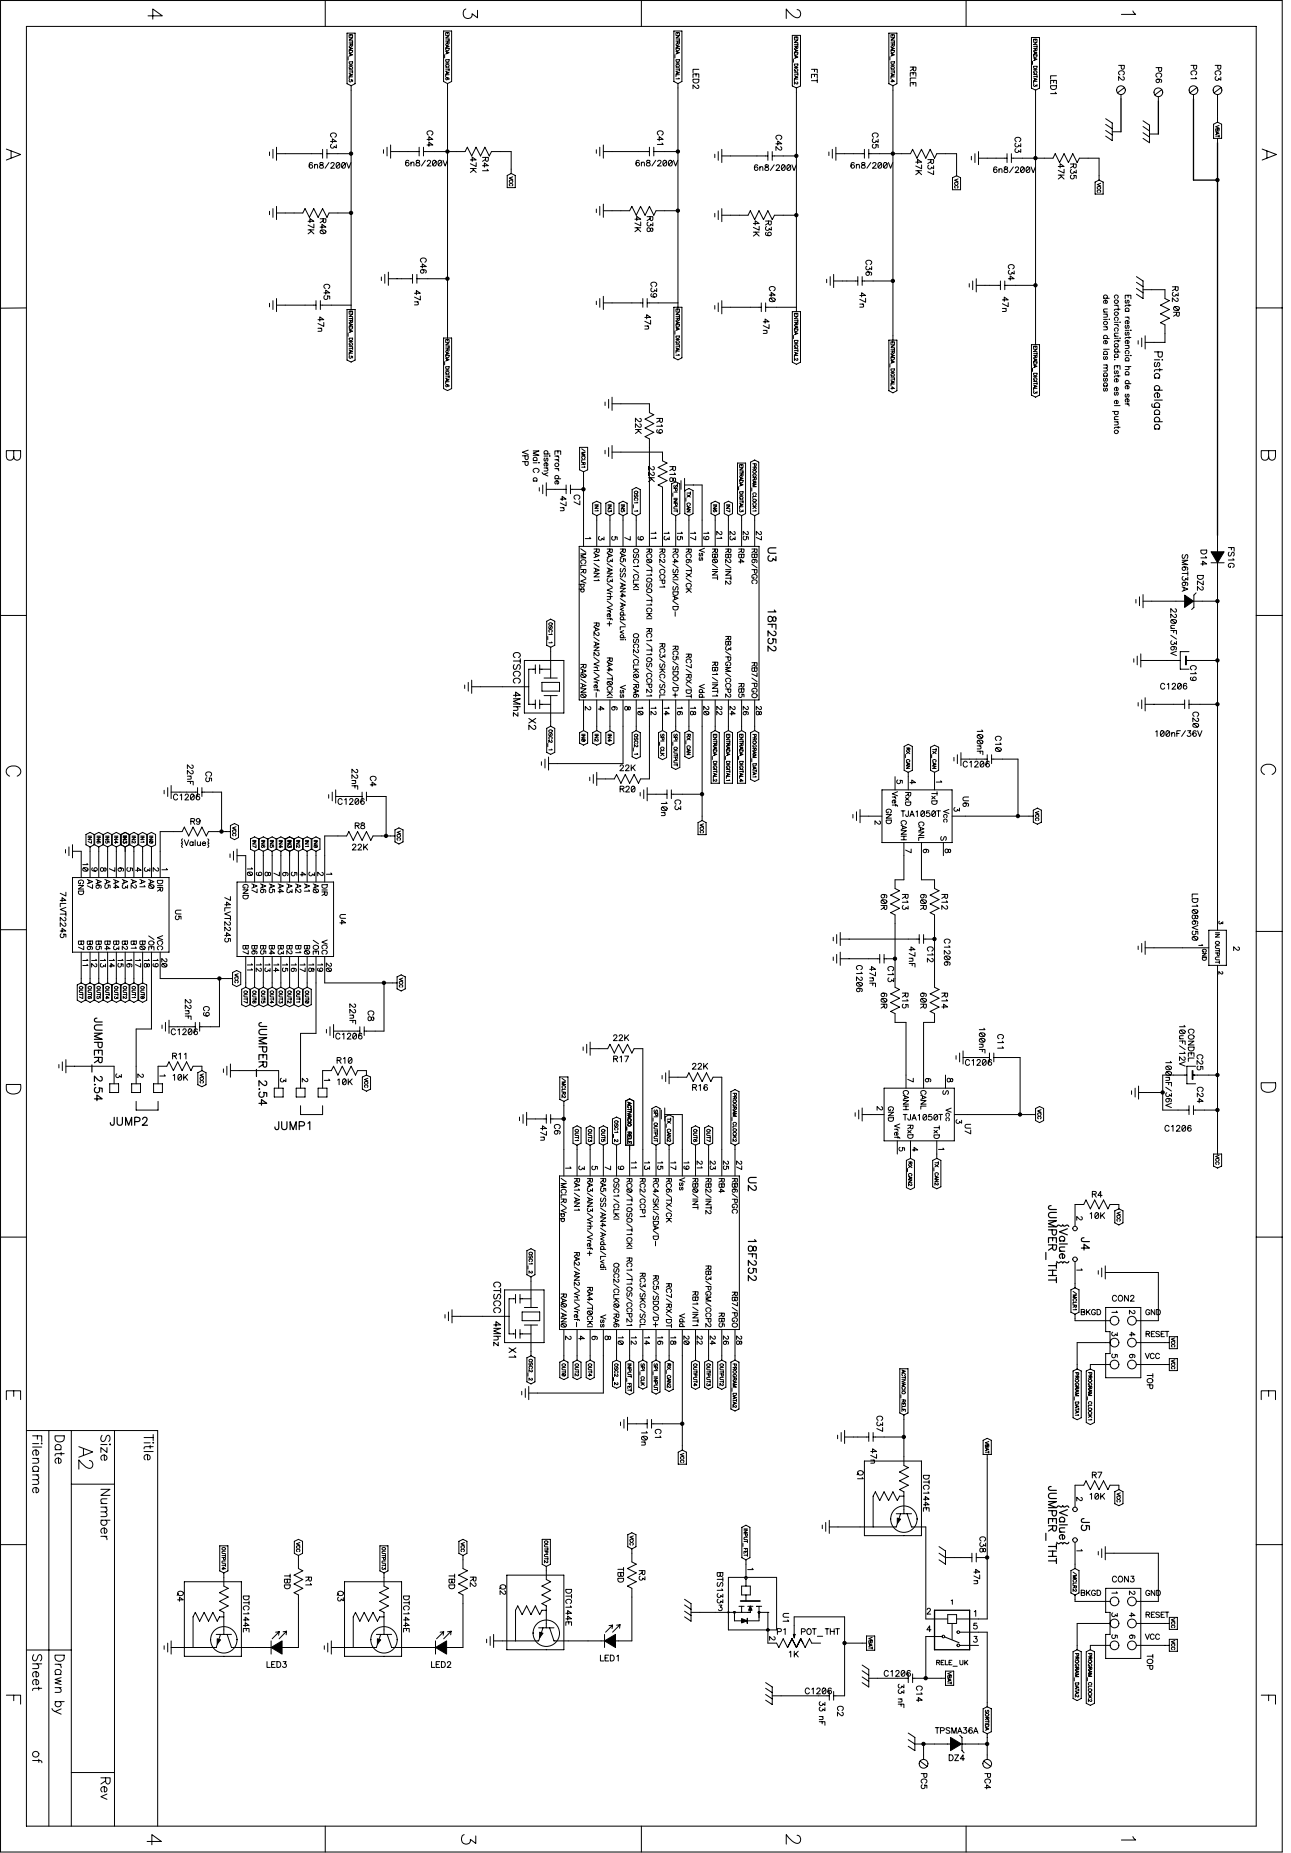
[picture p118: page 1]
