DaveWindWatcher/Design-Tools/(list of files, drawings)

Other design files:
Practiques/Practica3/LIB_PIC18F258-I_SO/PIC18F258-I_SO/Altium/PIC18F258-I_SO.SchLib
Practiques/Practica3/LIB_PIC18F258-I_SO/PIC18F258-I_SO/Altium/SOIC127P1034X264-28N.PcbLib
