DaveWindWatcher/Design-Tools/Practiques/Practica3/DavidMiravent_AidarIglesias_P3/AidarIglesias_DavidMiravent_P3.kicad_pcb

## KiCad design Practiques/Practica3/DavidMiravent_AidarIglesias_P3/AidarIglesias_DavidMiravent_P3.kicad_pcb (2023-03-13)

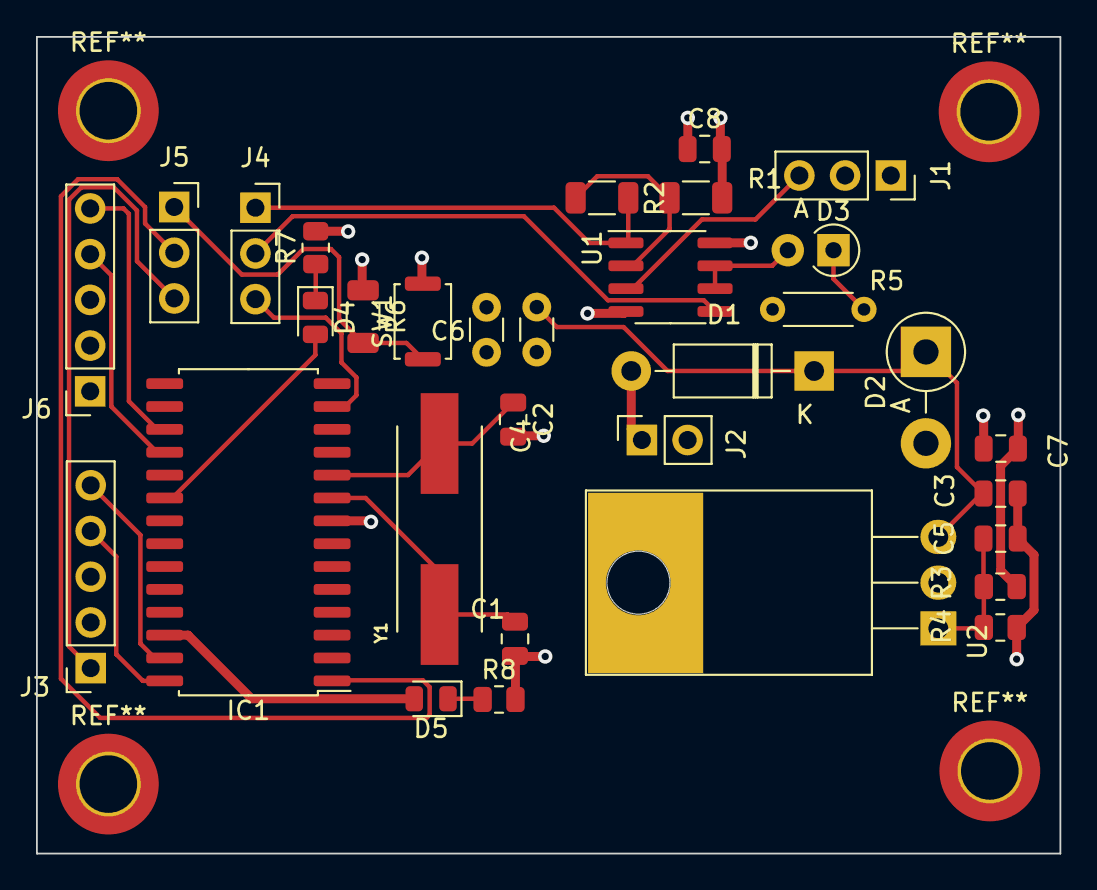
[picture p119: board AidarIglesias_DavidMiravent_P3.kicad_pcb from above]

Board: 4 copper layers, 56.9 x 45.4 mm, 32 parts (0 on the bottom side), 25 nets.

Parts:
C1, C2: 30p; C_0805_2012Metric
C3, C5, C7, C8: 100n; C_0805_2012Metric
C4, C6: 1u; C_Disc_D3.0mm_W1.6mm_P2.50mm
D1: 1N4002; D_DO-41_SOD81_P10.16mm_Horizontal
D2: 15V; D_5W_P5.08mm_Vertical_AnodeUp
D3: LED; D_A-405_P2.54mm_Vertical_AnodeUp
D4: LED_RED; LED_0805_2012Metric
D5: LED_BLUE; LED_0805_2012Metric
IC1: PIC18F258-I_SO; SOIC-28W_7.5x17.9mm_P1.27mm
J1: ANALOG INPUT; PinSocket_1x03_P2.54mm_Vertical
J2: Screw_Terminal_01x02; PinSocket_1x02_P2.54mm_Vertical
J3: PROGRAMMING CON; PinSocket_1x05_P2.54mm_Vertical
J4: JP2; PinSocket_1x03_P2.54mm_Vertical
J5: JP1; PinSocket_1x03_P2.54mm_Vertical
J6: USART CON; PinSocket_1x05_P2.54mm_Vertical
R1: 100k; R_1206_3216Metric
R2: 68k; R_1206_3216Metric
R3: 2.2k; R_0805_2012Metric
R4: 1k; R_0805_2012Metric
R5: 1k; R_Axial_DIN0204_L3.6mm_D1.6mm_P5.08mm_Horizontal
R6: 4.7k; R_1206_3216Metric
R7: 220; R_0805_2012Metric
R8: 100; R_0805_2012Metric
SW1: SW_Push; SW_Push_SPST_NO_Alps_SKRK
U1: LT1492; SOIC-8_3.9x4.9mm_P1.27mm
U2: LM1117-ADJ; TO-220-3_Horizontal_TabDown
Y1: ABLS2-16.000MHZ-D4Y-T; XTAL_ABLS2-16.000MHZ-D4Y-T

Connections:
+VCC: C6.1, C7.1, C8.1, J1.1, J3.2, J6.3, R3.1, R6.1, R7.2, U1.8 (V+), U2.2 (VO), U2.4
/VAMP: J4.1, R2.2, U1.1
/V_{div}: C5.1, R3.2, R4.1, U2.1 (ADJ)
/V_{in}: C3.1, C4.1, D1.1 (K), D2.1 (K), U2.3 (VI)
/Vdd: D4.2 (A), IC1.20 (VDD)
/Vfbk: R1.2, R2.1, U1.2 (-)
/Vled: D3.1 (K), R5.1
/Vledb: D5.1 (K), R8.1
/Vledr: D4.1 (K), R7.1
/Vsw: J5.1, R6.2, SW1.1
GND: C1.2, C2.2, C3.2, C4.2, C5.2, C6.2, C7.2, C8.2, D2.2 (A), IC1.8 (VSS_1), J1.2, J2.2, J3.3, J6.1, R1.1, R4.2, R5.2, R8.2, SW1.2, U1.4 (V-)
MCLR: IC1.1 (~MCLR/VPP), J5.2
PGC: IC1.27 (RB6/PGC), J3.5
PGD: IC1.28 (RB7/PGD), J3.4
PGM: D5.2 (A), IC1.26 (RB5/PGM)
PROG_MCLR: J3.1, J5.3
PWM: IC1.13 (RC2/CCP1), J4.3
RX: IC1.18 (RC7/RX/DT), J6.4
TX: IC1.17 (RC6/TX/CK), J6.5
VBAT: D1.2 (A), J2.1
Vdrive: J4.2, U1.5 (+)
Vin: J1.3, U1.3 (+)
Vout: D3.2 (A), U1.6 (-), U1.7
XTAL1: C1.1, IC1.9 (OSC1/CLKI), Y1.1
XTAL2: C2.1, IC1.10 (OSC2/CLKO/RA6), Y1.2
