DaveWindWatcher/Design-Tools/Practiques/Practica2/AidarIglesias_DavidMiravent_P2-20230312T112003Z-001/AidarIglesias_DavidMiravent_P2/AidarIglesias_DavidMiravent_P2.kicad_pcb

## KiCad design Practiques/Practica2/AidarIglesias_DavidMiravent_P2-20230312T112003Z-001/AidarIglesias_DavidMiravent_P2/AidarIglesias_DavidMiravent_P2.kicad_pcb (2023-03-13)

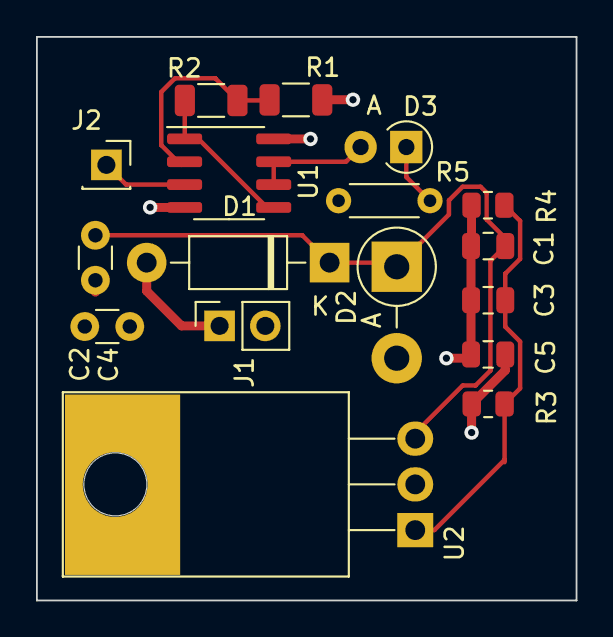
[picture p120: board Practiques/Practica2/AidarIglesias_DavidMiravent_P2-20230312T112003Z-… from above]

Board: 4 copper layers, 30.0 x 31.3 mm, 17 parts (0 on the bottom side), 10 nets.

Parts:
C1, C3, C5: 100n; C_0805_2012Metric
C2, C4: 1u; C_Disc_D3.0mm_W1.6mm_P2.50mm
D1: 1N4002; D_DO-41_SOD81_P10.16mm_Horizontal
D2: 15V; D_5W_P5.08mm_Vertical_AnodeUp
D3: LED; D_A-405_P2.54mm_Vertical_AnodeUp
J1: Screw_Terminal_01x02; PinSocket_1x02_P2.54mm_Vertical
J2: Conn_01x01_Pin; PinSocket_1x01_P2.54mm_Vertical
R1: 100k; R_1206_3216Metric
R2: 68k; R_1206_3216Metric
R3: 2.2k; R_0805_2012Metric
R4: 1k; R_0805_2012Metric
R5: 1k; R_Axial_DIN0204_L3.6mm_D1.6mm_P5.08mm_Horizontal
U1: LT1492; SOIC-8_3.9x4.9mm_P1.27mm
U2: LM1117-ADJ; TO-220-3_Horizontal_TabDown

Connections:
+VCC: C4.1, C5.1, R3.1, U1.8 (V+), U2.2 (VO), U2.4
/V_{div}: C3.1, R3.2, R4.1, U2.1 (ADJ)
/V_{in}: C1.1, C2.1, D1.1 (K), D2.1 (K), U2.3 (VI)
GND: C1.2, C2.2, C3.2, C4.2, C5.2, D2.2 (A), J1.2, R1.1, R4.2, R5.2, U1.4 (V-)
unnamed: D3.1 (K), R5.1
unnamed: R1.2, R2.1, U1.2 (-)
VAMP: R2.2, U1.1, U1.5 (+)
VBAT: D1.2 (A), J1.1
Vin: J2.1, U1.3 (+)
Vout: D3.2 (A), U1.6 (-), U1.7
