DaveWindWatcher/Design-Tools/Practiques/Practica1/DavidMiravent_AidarIglesias_Practica1/DavidMiravent_AidarIglesias_Practica1.kicad_pcb

## KiCad design Practiques/Practica1/DavidMiravent_AidarIglesias_Practica1/DavidMiravent_AidarIglesias_Practica1.kicad_pcb (2023-03-13)

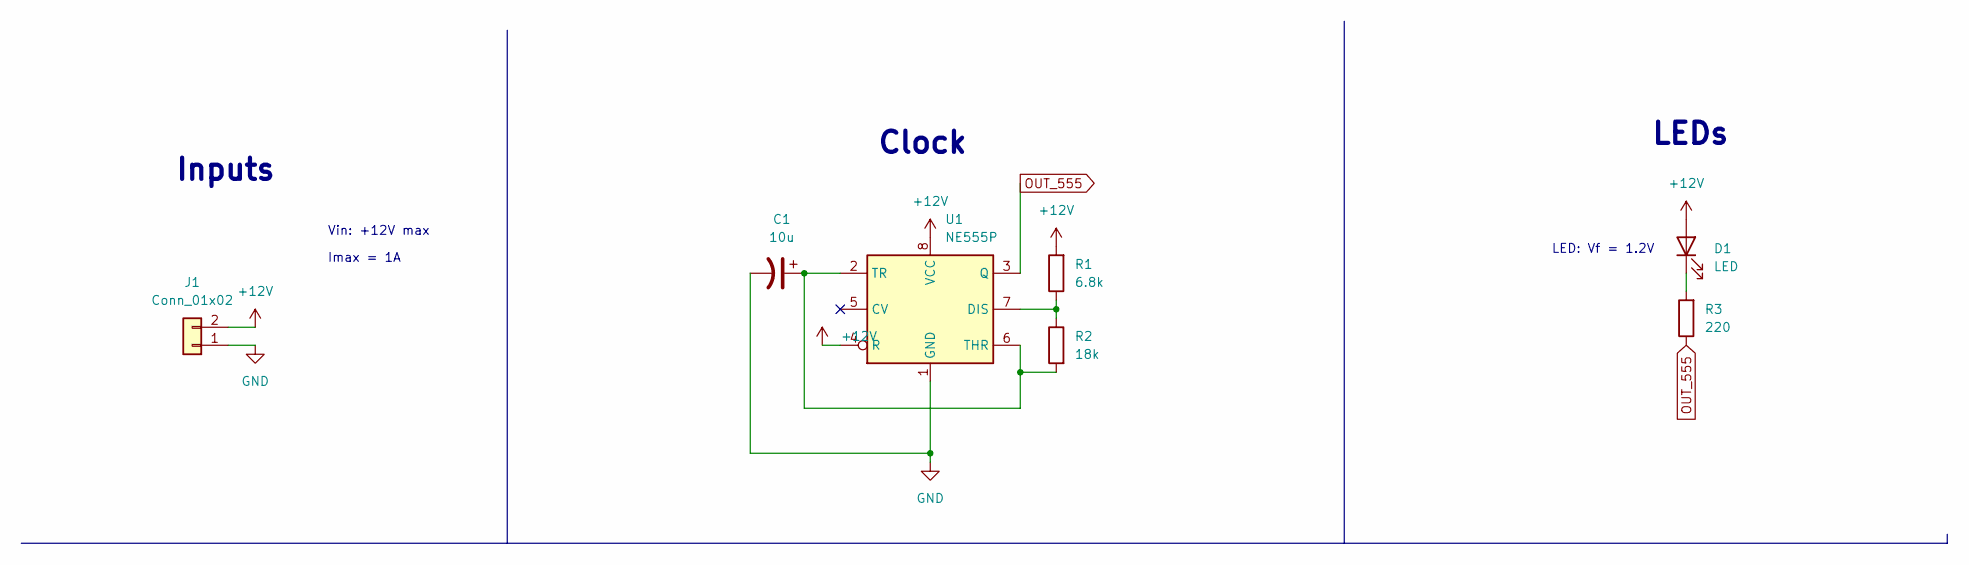
[picture p121: schematic DavidMiravent_AidarIglesias_Practica1.kicad_sch]

Parts:
C1: 10u; CP_Radial_D10.0mm_P3.80mm
D1: LED; LED_D5.0mm_FlatTop
J1: Conn_01x02; TerminalBlock_bornier-2_P5.08mm
R1: 6.8k; R_1206_3216Metric
R2: 18k; R_1206_3216Metric
R3: 220; R_1206_3216Metric
U1: NE555P; DIP-8_W7.62mm

Connections:
+12V: D1.2 (A), J1.2, R1.2, U1.4 (R), U1.8 (VCC)
GND: C1.2, J1.1, U1.1 (GND)
unnamed: C1.1, R2.2, U1.2 (TR), U1.6 (THR)
unnamed: D1.1 (K), R3.2
unnamed: R1.1, R2.1, U1.7 (DIS)
OUT_555: R3.1, U1.3 (Q)

Notes on the sheet:
Vin: +12V max
Inputs
Imax = 1A
LED: Vf = 1.2V
LEDs
Clock

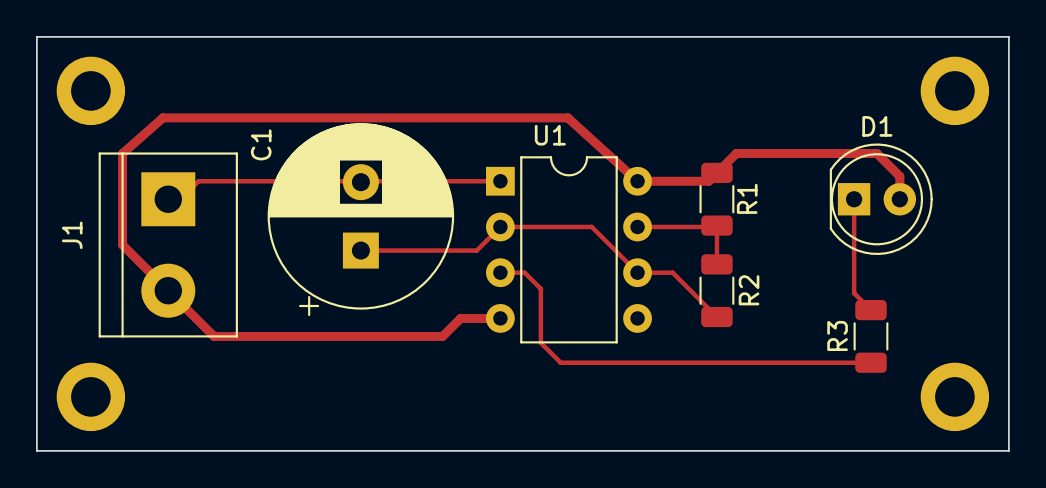
[picture p122: board DavidMiravent_AidarIglesias_Practica1.kicad_pcb from above]

Board: 2 copper layers, 54.0 x 23.0 mm, 7 parts (0 on the bottom side), 6 nets.
