DaveWindWatcher/Design-Tools/Practiques/Practica3/DavidMiravent_AidarIglesias_P3/AidarIglesias_DavidMiravent_P3.kicad_pcb

## KiCad design Practiques/Practica2/DavidMiravent_AidarIglesias_Practica2_TecniquesBasiques/DavidMiravent_AidarIglesias_Practica2_ReguladorAlimentacio/DavidMiravent_AidarIglesias_Practica2_ReguladorAlimentacio.kica…

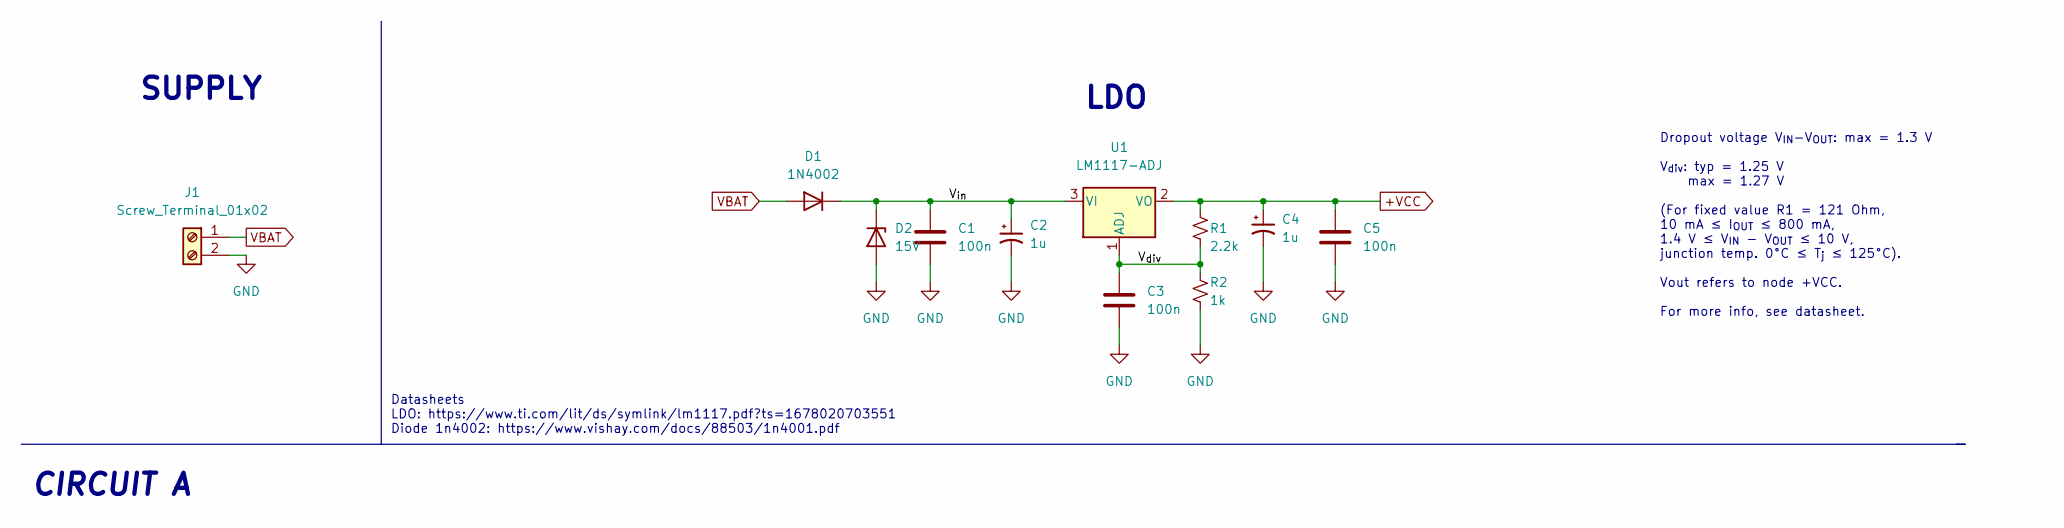
[picture p123: schematic DavidMiravent_AidarIglesias_Practica2_ReguladorAlimentacio.kicad_sch, Pràctica 2 - Disseny B: Regulador d'alimentació]

Parts:
C1, C3, C5: 100n; C_0805_2012Metric
C2, C4: 1u; C_Disc_D3.0mm_W1.6mm_P2.50mm
D1: 1N4002; D_DO-41_SOD81_P10.16mm_Horizontal
D2: 15V; D_5W_P5.08mm_Vertical_AnodeUp
J1: Screw_Terminal_01x02; Wago_734-132_1x02_P3.50mm_Vertical
R1: 2.2k; R_0805_2012Metric
R2: 1k; R_0805_2012Metric
U1: LM1117-ADJ; TO-220-3_Horizontal_TabDown

Connections:
+VCC: C4.1, C5.1, R1.1, U1.2 (VO)
/V_{div}: C3.1, R1.2, R2.1, U1.1 (ADJ)
/V_{in}: C1.1, C2.1, D1.1 (K), D2.1 (K), U1.3 (VI)
GND: C1.2, C2.2, C3.2, C4.2, C5.2, D2.2 (A), J1.2, R2.2
VBAT: D1.2 (A), J1.1

Notes on the sheet:
Dropout voltage V_{IN}-V_{OUT}: max = 1.3 V V_{div}: typ = 1.25 V max = 1.27 V (For fixed value R1 = 121 Ohm, 10 mA ≤ I_{OUT} ≤ 800 mA, 1.4 V ≤ V_{IN} - V_{OUT} ≤ 10 V, junction temp. 0°C ≤ T_{j} ≤ 125°C). Vout refers to node +VCC. For more info, see datasheet.
CIRCUIT A
SUPPLY
Datasheets LDO: https://www.ti.com/lit/ds/symlink/lm1117.pdf?ts=1678020703551 Diode 1n4002: https://www.vishay.com/docs/88503/1n4001.pdf
LDO

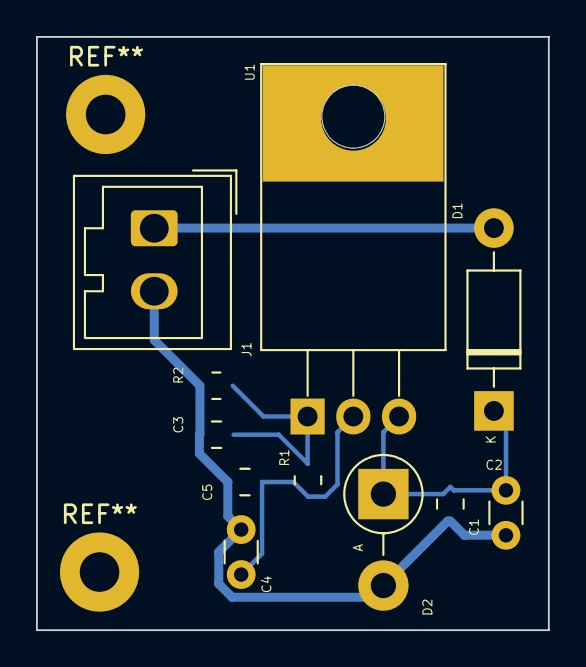
[picture p124: board DavidMiravent_AidarIglesias_Practica2_ReguladorAlimentacio.kicad_pcb from above]

Board: 4 copper layers, 28.4 x 33.0 mm, 11 parts (0 on the bottom side), 5 nets.
