DaveWindWatcher/Design-Tools/Practiques/Practica2/DavidMiravent_AidarIglesias_Practica2_TecniquesBasiques/AidarIglesias_DavidMiravent_P2-20230306T225125Z-001/AidarIglesias_DavidMiravent_P2/AidarIglesias_DavidMiravent_P2.kicad_pcb

## KiCad design Practiques/Practica2/DavidMiravent_AidarIglesias_Practica2_TecniquesBasiques/AidarIglesias_DavidMiravent_P2-20230306T225125Z-001/AidarIglesias_DavidMiravent_P2/AidarIglesias_DavidMiravent_P2.kicad_pcb (2023-03-13)

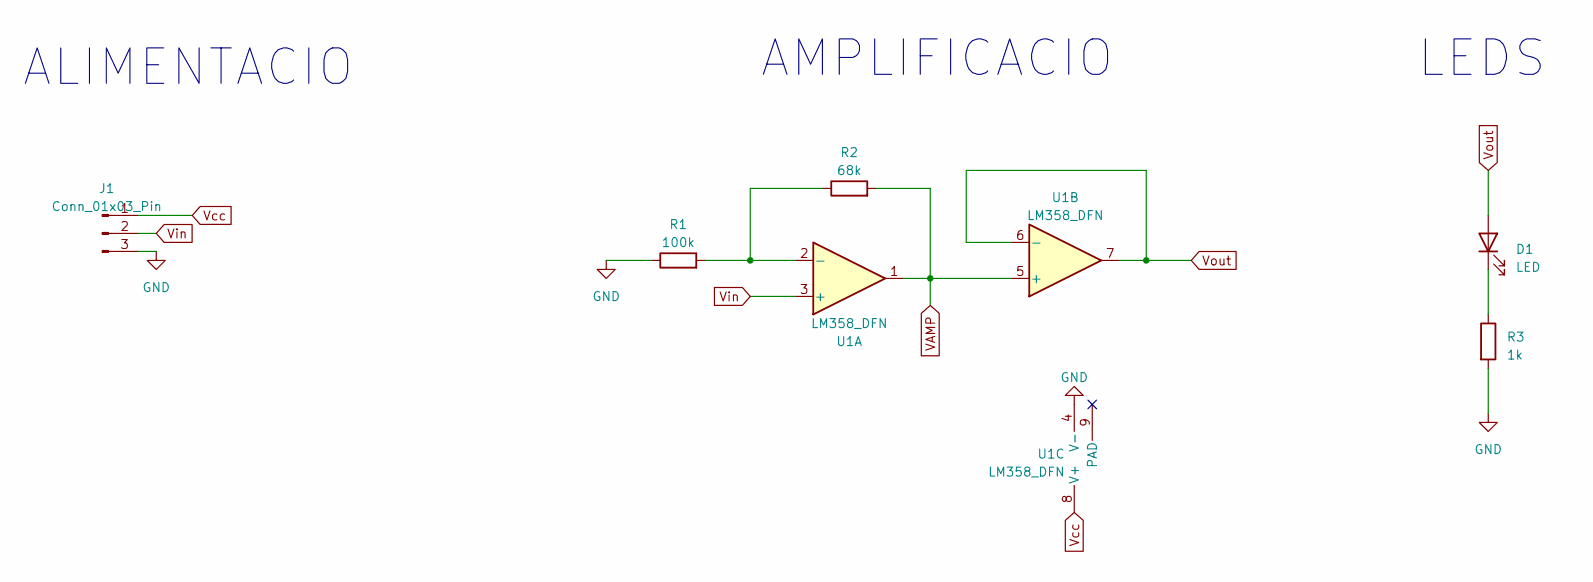
[picture p125: schematic AidarIglesias_DavidMiravent_P2.kicad_sch]

Parts:
D1: LED; D_A-405_P2.54mm_Vertical_AnodeUp
J1: Conn_01x03_Pin; PinHeader_1x03_P2.54mm_Vertical
R1: 100k; R_1206_3216Metric
R2: 68k; R_1206_3216Metric
R3: 1k; R_Axial_DIN0204_L3.6mm_D1.6mm_P5.08mm_Horizontal
U1: LM358_DFN; SOIC-8-1EP_3.9x4.9mm_P1.27mm_EP2.29x3mm

Connections:
GND: J1.3, R1.1, R3.2, U1.4 (V-)
unnamed: D1.1 (K), R3.1
unnamed: R1.2, R2.1, U1.2 (-)
VAMP: R2.2, U1.1, U1.5 (+)
Vcc: J1.1, U1.8 (V+)
Vin: J1.2, U1.3 (+)
Vout: D1.2 (A), U1.6 (-), U1.7

Notes on the sheet:
AMPLIFICACIO
LEDS
ALIMENTACIO

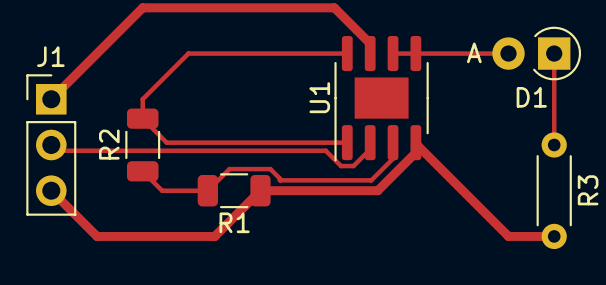
[picture p126: board Practiques/Practica2/DavidMiravent_AidarIglesias_Practica2_TecniquesB… from above]

Board: 2 copper layers, 6 parts (0 on the bottom side), 7 nets.
